Jiggolino/Hexapod/docs/Hexapod_Projektdokumentation_250919.docx

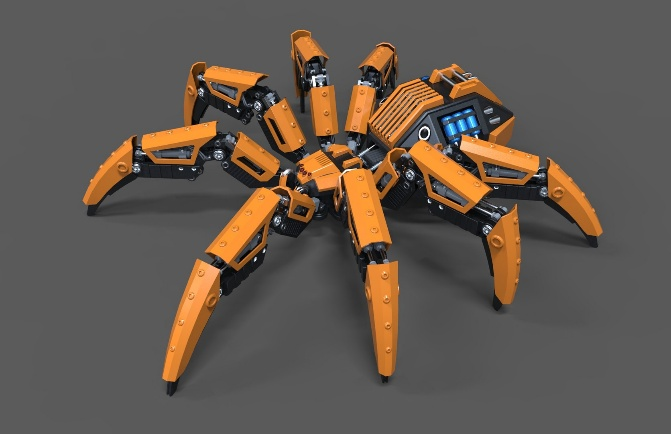
[picture p1: figure]
3d Model Robot Spider

# HEXAPOD

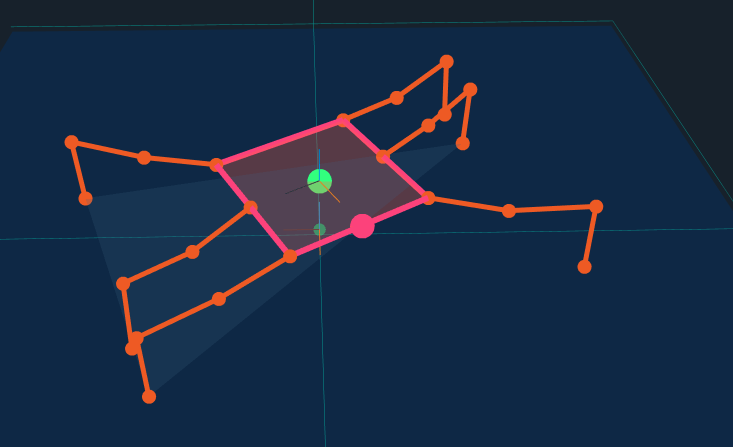
[picture p2: figure]
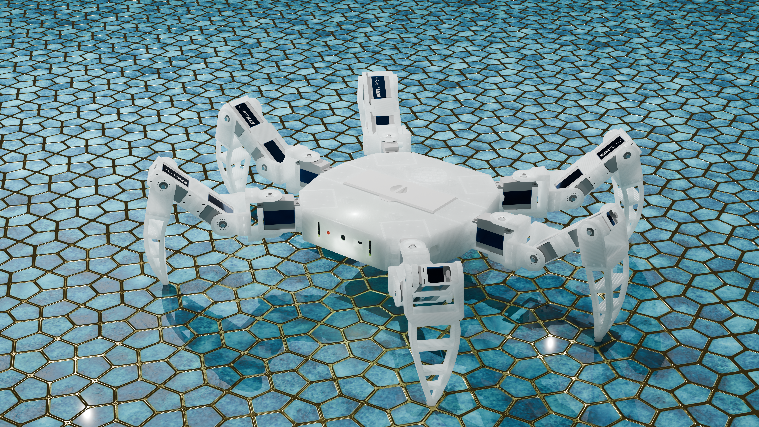
[picture p3: figure]
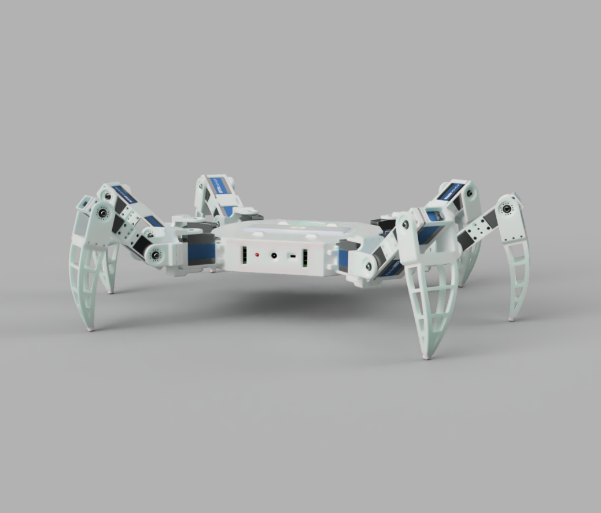
[picture p4: figure]
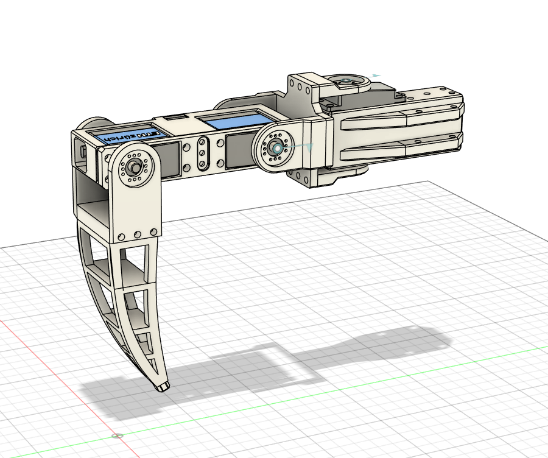
[picture p5: figure]
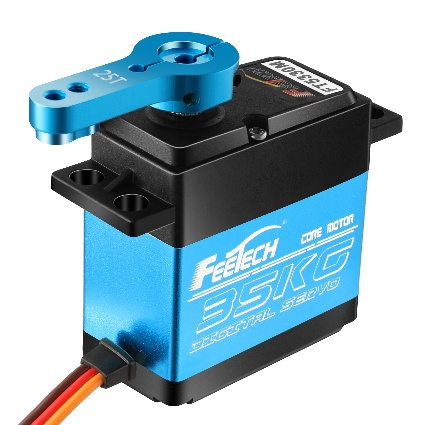
[picture p6: figure]
Servo Standard 35kg.cm Metal Gears (Feetech FT5330M)
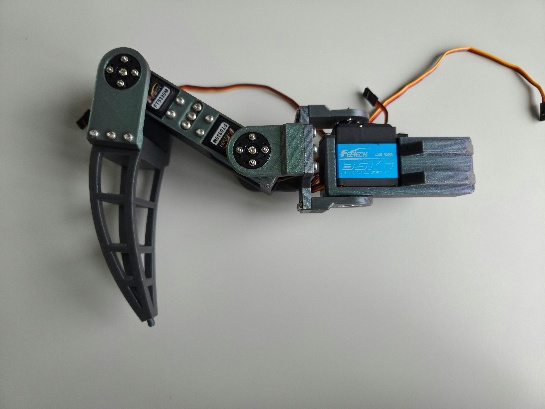
[picture p7: figure]
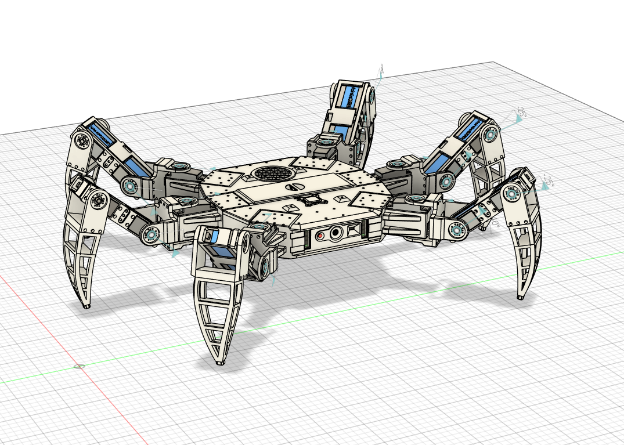
[picture p8: figure]

# Einleitung

Die Idee für dieses Projekt entstand, als ich auf YouTube den Kanal StewartTechnologies entdeckt habe. Dort habe ich zum ersten Mal einen Hexapod gesehen. Ein Hexapod ist ein Roboter mit sechs Beinen, der sich dadurch ganz anders bewegt als viele andere Roboter. Im Vergleich zu Robotern mit Rädern kann er auch auf unebenem Boden stabil stehen und sich fortbewegen. Im Gegensatz zu zweibeinigen oder vierbeinigen Robotern hat er durch die sechs Beine eine hohe Standfestigkeit, da immer mehrere Beine Bodenkontakt haben. Das macht ihn sehr vielseitig und für viele Experimente interessant.

Ein Hexapod gehört zu den sogenannten Beinrobotern. Diese Roboter sind besonders spannend, weil sie Bewegungen nachahmen, die man sonst nur aus der Natur kennt, zum Beispiel von Insekten oder Spinnen. Durch die vielen Gelenke in den Beinen kann ein Hexapod in alle Richtungen laufen und sich sogar drehen, ohne den Platz zu wechseln.

In diesem Projekt soll ein eigener Hexapod entwickelt und gebaut werden. Das Ziel ist es, ein Modell zu erstellen, das leicht, stabil und einfach steuerbar ist. Neben den grundlegenden Funktionen wie der Fernsteuerung und der sicheren Stromversorgung soll der Roboter auch modular aufgebaut sein, damit er später erweitert oder angepasst werden kann. Dieses Projekt verbindet Mechanik, Elektronik und Programmierung und soll zeigen, wie vielseitig ein Hexapod eingesetzt werden kann.

# Anforderungen

Ich habe eine Anforderungsliste in Excel gemacht mit 2 Spalten, Funktionale und Nicht Funktionale. Das Beispiel von Herr Jäger wurde als Vorlage für meine Anforderungsliste genommen. Man kann die Liste unter:/Hexapod/ requirements/ Hexapod_Anforderung_250916.xlsx oder unten auf dem Bild.

- Das Hexapod kann per Fernbedienung gesteuert werden. Begründung: Eine Fernsteuerung macht die Bedienung einfach und erlaubt es, das Hexapod flexibel einzusetzen.
- Jedes Bein kann sich in allen Achsen bewegen. Begründung: Dadurch sind viele Bewegungsarten möglich, was das Hexapod vielseitiger macht.
- Das Hexapod wird mit 6V–8,4V gespeist. Begründung: Dieser Spannungsbereich ist ideal für die eingesetzten Servomotoren und Elektronik.
- Das Hexapod kann 500g Extragewicht tragen. Begründung: Damit ist es möglich, zusätzliche Sensoren oder Module zu befestigen.
- Das Hexapod hat einen Indikator, der anzeigt, wenn die Kamera benutzt wird. Begründung: Dies erhöht die Sicherheit und macht klar sichtbar, ob gerade eine Videoaufnahme läuft.
- Das Hexapod muss in jeder Situation in den Zustand „unarmed“ gebracht werden können. Begründung: Dadurch kann man das Hexapod im Notfall sofort stoppen und Schäden vermeiden.
- Der Akku kann konstant überwacht und per Software ausgeschaltet werden. Begründung: So wird der Akku geschützt und eine sichere Nutzung gewährleistet.
- Die Leistungsaufnahme darf maximal 850W betragen. Begründung: Diese Begrenzung verhindert Überlastung und Schäden an den Bauteilen.
- Das Hexapod hat einen Anschluss für Erweiterungen (I2C, 5V, GND, 2x GPIO). Begründung: Mit diesen Anschlüssen können später zusätzliche Module einfach angeschlossen werden.
- Es gibt einen Überstromschutz und einen Unterspannungsschutz für den Akku. Begründung: Diese Schutzfunktionen verlängern die Lebensdauer des Akkus und erhöhen die Sicherheit.
- Der Controller ist ein PlayStation-Controller. Begründung: Ein PlayStation-Controller ist weit verbreitet, einfach zu bedienen und bietet viele Tasten für Steuerbefehle.
- Das Hexapod wiegt unter 3kg. Begründung: Ein geringes Gewicht macht den Transport einfacher und schont die Servomotoren.
- Der 3D-Druck wird mit PETG oder ABS ausgeführt. Begründung: Diese Materialien sind stabil und hitzebeständig, was für die Belastung im Betrieb wichtig ist.
- Das Hexapod ist mit ausgestreckten Beinen kürzer als 1 Meter. Begründung: Dadurch bleibt der Roboter handlich und gut transportierbar.
- Das Mainboard ist ein Eigendesign. Begründung: Ein eigenes Design kann optimal an die Anforderungen des Projekts angepasst werden.
- So viele Teile wie möglich sollen verschraubt und so wenig Klebstoff wie möglich verwendet werden. Begründung: Verschraubte Teile sind stabiler und lassen sich leichter reparieren oder austauschen.
- Das Hexapod darf 80°C nicht überschreiten. Begründung: Überhitzung kann Bauteile beschädigen und die Sicherheit gefährden.
- Das Hexapod muss im „unarmed“-Zustand programmierbar sein. Begründung: Damit können Änderungen gemacht werden, ohne dass eine Gefahr durch Bewegungen entsteht.
- Das Hexapod hat eine IMU (Internal Measurement Unit). Begründung: Die IMU misst Beschleunigung und Drehung, was für eine präzise Steuerung wichtig ist.
- Die Batterie kann einfach und schnell ausgetauscht werden. Begründung: Dies spart Zeit beim Betrieb und macht das Hexapod praktischer.
- Jedes Bein kann einzeln entfernt werden. Begründung: Dadurch sind Reparaturen einfacher möglich und defekte Teile können schnell ersetzt werden.
- Das Hexapod muss auch im zusammengebauten Zustand programmierbar sein. Begründung: So können Updates oder Änderungen ohne Auseinanderbauen gemacht werden.
- Die Füsse sind austauschbar. Begründung: Je nach Untergrund können passende Füsse eingesetzt werden, was die Einsatzmöglichkeiten erweitert.

Funktionale Anforderungen
# | Anforderung | Status

1 | Das Hexapod kann per Fernbedienung gesteuert werden. | Vom Kunden abgenommen
2 | Jedes Bein kann sich in allen Achsen bewegen. | Vom Kunden abgenommen
3 | Das Hexapod wird mit 6V-8,4V gespeist werden. | Vom Kunden abgenommen
4 | Das Hexapod kann 500g Extragewicht tragen. | Vom Kunden abgenommen
5 | Das Hexapod hat einen Indikator, der anzeigt, wenn die Kamera benutzt wird. | Vom Kunden abgenommen
6 | Das Hexapod muss in jeder situation in den Zustand "unarmed" gebracht werden können | Vom Kunden abgenommen
7 | Der Akku kann konstant überwacht und per Software ausgeschalten werden können. | Vom Kunden abgenommen
8 | Die Leistungsaufnahme kann maximal 850W betragen. | Vom Kunden abgenommen
9 | das Hexapod hat einen Anschluss für Erweiterungen mit folgenden Anschlüsse: I2C, 5V, GND, 2x GPIO | Vom Kunden abgenommen
10 | Es hat einen Überstromschutz und eine Unterspannungsschutz für den Akku. | Vom Kunden abgenommen
11 | Der Controller ist ein PlayStation-Controller. | Vom Kunden abgenommen
11 | Das Hexapod wiegt unter 3kg. | Vom Kunden abgenommen

Nichtfunktionale Anforderungen
# | Anforderung | Status

1 | Der 3D-Druck wird mit PETG oder ABS gedruckt werden. | Vom Kunden abgenommen
2 | Das Hexapod ist mit ausgestreckten Beinen unter einem Meter lang. | Vom Kunden abgenommen
3
4 | Das Mainboard ist ein Eigendesign. | Vom Kunden abgenommen
5 | Es sollen so viele Teile wie möglich verschraubt und so wenig Klebstoff wie möglich verwendet werden. | Vom Kunden abgenommen
6 | Das Hexapod darf 80°C nicht überschreiten. | Vom Kunden abgenommen
7 | Das Hexapod muss im "unarmed" Zustand programmierbar sein. | Vom Kunden abgenommen
8 | Das Hexapod hat eine IMU (Internal Mesurment Unit, kann beschleunigung und rotation in allen Achsen messen). | Vom Kunden abgenommen
9 | Die Batterie kann einfach und schnell ausgetaust werden. | Vom Kunden abgenommen
10 | Jedes Bein kann einzeln entfernt werden. | Vom Kunden abgenommen
11 | Das Hexapod muss auch im komplett zusammengebauten Zustand noch programmierbar sein. | Vom Kunden abgenommen
12 | Die Füße sind austauschbar sein. | Vom Kunden abgenommen

# Planung

Für die Planung des Projekts habe ich mir zuerst ein geeignetes Tool ausgesucht. Nach dem Vergleichen mehrerer Möglichkeiten habe ich mich für das Online-Tool Miro entschieden. Dieses eignet sich besonders gut, weil ich von überall darauf zugreifen kann, es eine übersichtliche Benutzeroberfläche hat und die Erstellung von Plänen sehr einfach und flexibel ist.

Als das Tool feststand, habe ich begonnen, die Anforderungen in grobe Schritte und Meilensteine einzuteilen. Jeder Schritt bekam eine geschätzte Zeitdauer, und bei den Meilensteinen habe ich ein genaues Datum eingetragen. In dem Zeitplan haben die Schritte, an welchen ich arbeite, einen hellgrünen Rahmen und die schon gemacht sind haben einen grünen Rahmen. Ich habe Dazu auch noch die Meilensteine in verschiedenen Farben eingefärbt. Die Zeitangaben habe ich möglichst realistisch geschätzt, basierend auf meinen bisherigen Erfahrungen. Am Ende habe ich die geschätzten Zeiten addiert, den Wert verdoppelt und zusätzlich 50 Stunden dazugezählt. Der Grund dafür ist, dass man sich bei Projekten oft verschätzt und viele Arbeiten mehr Zeit beanspruchen, als man zuerst denkt. So kam ich auf eine Gesamtzeit von rund 250 Stunden.

Der Zeitplan beginnt am 28.08.2025 mit der Projektbeschreibung, dem organisatorischen Teil und der Erstellung des Zeitplans. Danach folgt die Suche nach geeigneten Servomotoren, der Kauf von drei Servos und der erste 3D-Entwurf für ein Bein. Dieses Bein wird gedruckt, zusammengebaut und getestet. So entsteht bis zum 26.09.2025 der erste Prototyp.

Im nächsten Schritt wird das Design des Körpers entwickelt und die restlichen Teile werden gesucht. Nach dem ersten fertigen 3D-Design am 09.10.2025 folgen das Drucken des Körpers und die Überarbeitung der Beine. Danach werden fünf weitere Beine gedruckt, sodass am 12.11.2025 das finale 3D-Design abgeschlossen ist. Anschliessend wird das Hexapod zum ersten Mal komplett zusammengesetzt.

Parallel dazu wird die Elektronik geplant. Dazu gehört das Design der eigenen Leiterplatte (PCB), das Bestellen der Bauteile und die Fertigung der Platine. Am 19.11.2025 ist die finale Platine fertiggestellt. Danach wird die Elektronik mit Oszilloskop und Multimeter getestet und in das Hexapod eingebaut.

Am 10.12.2025 steht der erste komplette Aufbau des Hexapods. Danach beginnt eine längere Testphase von rund 16 Stunden. Dabei werden Fehler im Design gesucht und behoben. Am 08.01.2026 ist die Dokumentation abgeschlossen, und am 09.01.2026 ist das Hexapod so weit, dass es funktioniert und präsentiert werden kann.

In den letzten Tagen bis zum 15.01.2026 wird die Programmierung für die Demonstration vorbereitet, sodass das Hexapod am Ende in einer Vorführung präsentiert werden kann.

Man kann den Zeitplan unten Auf dem Bild sehen oder in dem Browser mit diesem Link:

https://miro.com/app/board/uXjVJN4mAOU=/

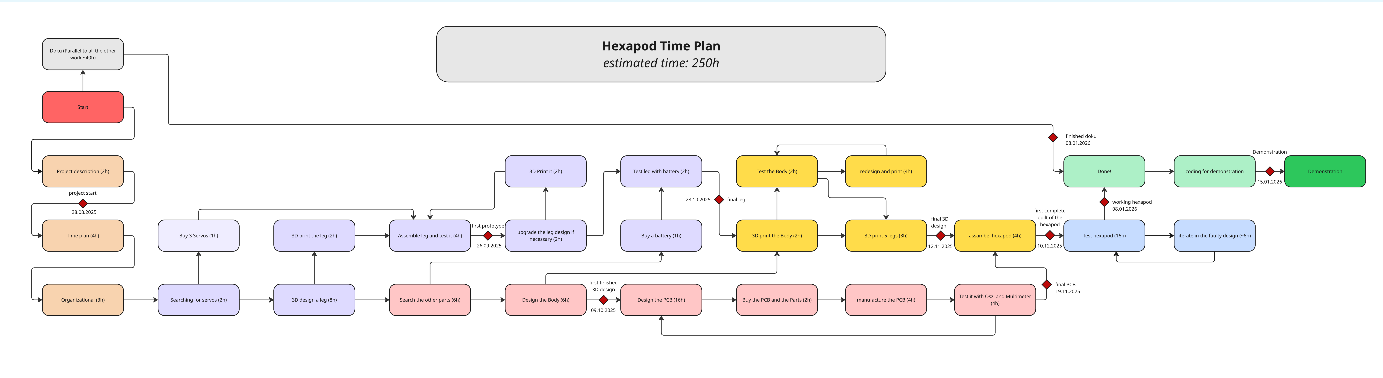
[picture p9: figure]

# Analyse

REPLACEME

# Realisierung

REPLACEME

# Testen

REPLACEME

# Reflektion

REPLACEME

# Selbständigkeitserklärung

REPLACEME

# Arbeitsjournal

In diesem Excelfile befindet sich das Arbeitsjournal.

# Anhang

REPLACEME

# Quellen

Ideen:

- https://www.youtube.com/@StewartTechnologies
- https://chatgpt.com/
- https://gemini.google.com/app

Bilder:

- https://p.turbosquid.com/ts-thumb/S3/DcNrTi/hCynQxiG/01.747/jpg/1530644260/1920x1080/fit_q87/9920db83fd3fdb3f5ec1dace9df54c11408f45dd/01.747.jpg
- https://grobotronics.com/images/detailed/118/hfe4c15bd1f4446558cd29e1a1951516ca_grobo.jpg
- https://hexapod.netlify.app/walking-gaits

Assets:

- https://grabcad.com/library/raspberry-pi-5-2
- https://grabcad.com/library/raspberry-pi-camera-4
- https://grabcad.com/library/raspberry-pi-5-active-cooler-1
- https://www.blenderkit.com/
- https://sketchfab.com/feed
- https://www.fab.com/
- https://www.snapeda.com/home/

19.09.2025 Seite 1 von 2

Hexapod Linus Meier
