Jiggolino/Hexapod/requirements/1_Semester/Hexapod_Anforderung_250916.xlsx

Funktionale Anforderungen |  |  | Nichtfunktionale Anforderungen
# | Anforderung | Status | # | Anforderung | Status
1 | Das Hexapod kann per Fernbedienung gesteuert werden. | Vom Kunden abgenommen | 1 | Der 3D-Druck wird mit PETG oder ABS gedruckt werden. | Vom Kunden abgenommen
2 | Jedes Bein kann sich in allen Achsen bewegen. | Vom Kunden abgenommen | 2 | Das Hexapod ist mit ausgestreckten Beinen unter einem Meter lang. | Vom Kunden abgenommen
3 | Das Hexapod wird mit 6V-8,4V gespeist werden. | Vom Kunden abgenommen | 3 | Das Mainboard ist ein Eigendesign. | Vom Kunden abgenommen
4 | Das Hexapod kann 500g Extragewicht tragen. | Vom Kunden abgenommen | 4 | Es sollen so viele Teile wie möglich verschraubt und so wenig Klebstoff wie möglich verwendet werden. | Vom Kunden abgenommen
5 | Das Hexapod hat einen Indikator, der anzeigt, wenn die Kamera benutzt wird. | Vom Kunden abgenommen | 5 | Das Hexapod darf 80°C nicht überschreiten. | Vom Kunden abgenommen
6 | Das Hexapod muss in jeder situation in den Zustand "unarmed" gebracht werden können | Vom Kunden abgenommen | 6 | Das Hexapod muss im "unarmed" Zustand programmierbar sein. | Vom Kunden abgenommen
7 | Der Akku kann konstant überwacht und per Software ausgeschalten werden können. | Vom Kunden abgenommen | 7 | Das Hexapod hat eine IMU (Internal Mesurment Unit, kann beschleunigung und rotation in allen Achsen messen). | Vom Kunden abgenommen
8 | Die Leistungsaufnahme kann maximal 850W betragen. | Vom Kunden abgenommen | 8 | Die Batterie kann einfach und schnell ausgetaust werden. | Vom Kunden abgenommen
9 | das Hexapod hat einen Anschluss für Erweiterungen mit folgenden Anschlüsse: I2C, 5V, GND, 2x GPIO | Vom Kunden abgenommen | 9 | Jedes Bein kann einzeln entfernt werden. | Vom Kunden abgenommen
10 | Es hat einen Überstromschutz und eine Unterspannungsschutz für den Akku. | Vom Kunden abgenommen | 10 | Das Hexapod muss auch im komplett zusammengebauten Zustand noch programmierbar sein. | Vom Kunden abgenommen
11 | Der Controller ist ein PlayStation-Controller. | Vom Kunden abgenommen | 11 | Die Füße sind austauschbar sein. | Vom Kunden abgenommen
11 | Das Hexapod wiegt unter 3kg. | Vom Kunden abgenommen
Funktionale Anforderungen Test |  |  | Nichtfunktionale Anforderungen Test
# | Anforderung | Status | # | Anforderung | Status | Column1
1 | Das Hexapod kann per Fernbedienung gesteuert werden. | Noch nicht Erreicht | 1 | Der 3D-Druck wird mit PETG oder ABS gedruckt werden. | Erreicht (PETG)
2 | Jedes Bein kann sich in allen Achsen bewegen. | Erreicht | 2 | Das Hexapod ist mit ausgestreckten Beinen unter einem Meter lang. | Erreicht (94.53cm)
3 | Das Hexapod wird mit 6V-8,4V gespeist werden. | Erreicht (5.8V-8.4V) | 3 | Das Mainboard ist ein Eigendesign. | Erreicht
4 | Das Hexapod kann 500g Extragewicht tragen. | Noch nicht Erreicht | 4 | Es sollen so viele Teile wie möglich verschraubt und so wenig Klebstoff wie möglich verwendet werden. | Erreicht (Alles aussert 2 Bauteile sind verschraubt)
5 | Das Hexapod hat einen Indikator, der anzeigt, wenn die Kamera benutzt wird. | Noch nicht Erreicht | 5 | Das Hexapod darf 80°C nicht überschreiten. | Erreicht (max temp = 65° (Raspberry pi 5 maximale core tempereatur)) | test unter vollast mit Ubuntu Server als OS
6 | Das Hexapod muss in jeder situation in den Zustand "unarmed" gebracht werden können | Noch nicht Erreicht | 6 | Das Hexapod muss im "unarmed" Zustand programmierbar sein. | Noch nicht Erreicht
7 | Der Akku kann konstant überwacht und per Software ausgeschalten werden können. | Noch nicht Erreicht | 7 | Das Hexapod hat eine IMU (Internal Mesurment Unit, kann beschleunigung und rotation in allen Achsen messen). | Erreicht
8 | Die Leistungsaufnahme kann maximal 850W betragen. | Noch nicht Erreicht | 8 | Die Batterie kann einfach und schnell ausgetaust werden. | Noch nicht Erreicht
9 | das Hexapod hat einen Anschluss für Erweiterungen mit folgenden Anschlüsse: I2C, 5V, GND, 2x GPIO | Erreicht (I2C, 5V 2x GPIO, 3.3V, 5.8-8.4V, ADC, SPI) | 9 | Jedes Bein kann einzeln entfernt werden. | Erreicht
10 | Es hat einen Überstromschutz und eine Unterspannungsschutz für den Akku. | Noch nicht Erreicht | 10 | Das Hexapod muss auch im komplett zusammengebauten Zustand noch programmierbar sein. | Erreicht
11 | Der Controller ist ein PlayStation-Controller. | Erreicht (PS5 Controller) | 11 | Die Füße sind austauschbar sein. | Erreicht
11 | Das Hexapod wiegt unter 3kg. | Nicht Erreicht (3.315Kg)
 |  |  |  |  | 9 von 11 Erreicht
Diese Test wurden von Linus Meier Durchgeführt am 07.01.2026 durchgeführt. |  | 4 von 11 Erreicht
