Jiggolino/Hexapod/requirements/2_Semester/Hexapod_Anforderung_250916.xlsx

Funktionale Anforderungen |  |  | Nichtfunktionale Anforderungen
# | Anforderung | Status | # | Anforderung | Status
1 | Das Hexapod kann per Fernbedienung gesteuert werden. | Vom Kunden abgenommen | 1 | Der Code ist Modular Aufgebaut dammit man Funktionen einfach ersetzen oder ändern kann | Vom Kunden abgenommen
2 | Jedes Bein kann sich in allen Achsen bewegen. | Vom Kunden abgenommen | 2 | Der Lowlevel code ist in C Programiert | Vom Kunden abgenommen
3 |  | Vom Kunden abgenommen | 3 | Die zeitkritischen funktionen werden mit einem Regelkreis und einer State-Mashine Programiert | Vom Kunden abgenommen
4 | Das Hexapod kann 500g Extragewicht tragen. | Vom Kunden abgenommen | 4 | Das benüzen der steuerung ist selbsterklärend | Vom Kunden abgenommen
5 | Das Hexapod hat einen Indikator, der anzeigt, wenn die Kamera benutzt wird. | Vom Kunden abgenommen | 5 | Es git eine Gebrauchsanleitung | Vom Kunden abgenommen
6 | Das Hexapod muss in jeder situation in den Ruhezustand gebracht werden können | Vom Kunden abgenommen | 6 | Die Einstellungen werden über ein WEB-Interface gemacht | Vom Kunden abgenommen
7 | Das Hexapod ist nicht Netzwerkabhängig | Vom Kunden abgenommen | 7 | Es gibt ein Realtime webinterface für alle sensoren und Daten | Vom Kunden abgenommen
8 | Es hat einen Überstromschutz und eine Unterspannungsschutz für den Akku. | Vom Kunden abgenommen | 8 | Jeder Code hat seine eigenen Tests und Protokolle | Vom Kunden abgenommen
9 | Der Controller ist ein PlayStation-Controller. | Vom Kunden abgenommen
10 | Man kann einfach zwischen den verschidenen kontrolirungs Methoden wechseln | Vom Kunden abgenommen
11 | Den Kamera feed kann man auf einem externen Blidschirm sich ansehen | Vom Kunden abgenommen
11 | Alle verzögerungen sollten unter 200ms sein | Vom Kunden abgenommen
12 | Der Regelkreis hat eine Frequenz von mindestens 50Hz für Zeitkritische aspekte | Vom Kunden abgenommen
