Jiggolino/Hexapod/parts/partlists/Mainboard/Parts.xlsx

Part list PCB
Purpose | part | seller | partnumber | manufacturer | datasheet | price | quantity | total price
ADC | ADS1115IRUGT | Digikey | 296-24935-1-ND | Texas Instruments | https://www.ti.com/lit/ds/symlink/ads1113.pdf?HQS=dis-dk-null-digikeymode-dsf-pf-null-wwe&ts=1756132663292 | CHF 5.03 | 1 | CHF 5.03
uC | ESP32-S3-WROOM-1-N8R8 | Digikey | 5407-ESP32-S3-WROOM-1-N8R8TR-ND | Espressif Systems | https://www.espressif.com/sites/default/files/documentation/esp32-s3-wroom-1_wroom-1u_datasheet_en.pdf | CHF 4.90 | 1 | CHF 4.90
PWM | PCA9685PW,118 | Digikey | 568-11925-1-ND | NXP USA Inc. | https://www.nxp.com/docs/en/data-sheet/PCA9685.pdf | CHF 2.21 | 2 | CHF 4.42
3.3V fixed regulator | AZ1117CH-3.3TRG1 | Digikey | AZ1117CH-3.3TRG1DITR-ND | Diodes Incorporated | https://www.diodes.com/assets/Datasheets/AZ1117C.pdf | CHF 0.13 | 1 | CHF 0.13
power MOSFET 100A | CSD17570Q5B | Digikey | 296-39993-2-ND | Texas Instruments | https://www.ti.com/general/docs/suppproductinfo.tsp?distId=10 | CHF 1.90 | 2 | CHF 3.80
MOFET / POWER EN | AO3400A | Digikey | 785-1000-2-ND | Alpha & Omega Semiconductor Inc. | https://mm.digikey.com/Volume0/opasdata/d220001/medias/docus/1133/AO3400A_ds.pdf | CHF 0.37 | 4 | CHF 1.48
USB C port | USB4105-GF-A | Digikey | 2073-USB4105-GF-ATR-ND | GCT | https://gct.co/files/specs/usb4105-spec.pdf | CHF 0.62 | 1 | CHF 0.62
PD Controller | AP33771DKZ-13 | Digikey | 31-AP33771DKZ-13TR-ND | Diodes Incorporated | https://www.diodes.com/assets/Datasheets/AP33771.pdf | CHF 1.42 | 1 | CHF 1.42
Level Shifter | TXS0102DCUR | Digikey | 296-21931-2-ND | Texas Instruments | https://www.ti.com/lit/ds/symlink/txs0102.pdf?ts=1756187465447 | CHF 0.56 | 1 | CHF 0.56
IMU | LSM6DSO32TR | Digikey | 497-LSM6DSO32CT-ND | STMicroelectronics | https://www.st.com/resource/en/datasheet/lsm6dso32.pdf | CHF 3.64 | 1 | CHF 3.64
OPV current sensing 200x | INA181A3IDBVR | Digikey | 296-47658-2-ND | Texas Instruments | https://www.ti.com/lit/ds/symlink/ina181.pdf | CHF 0.43 | 2 | CHF 0.86
 |  |  |  |  |  | CHF 0.00 | 0 | CHF 0.00
 |  |  |  |  |  | CHF 0.00 | 0 | CHF 0.00
 |  |  |  |  |  | CHF 0.00 | 0 | CHF 0.00
 |  |  |  |  |  | CHF 0.00 | 0 | CHF 0.00
 |  |  |  |  |  | CHF 0.00 | 0 | CHF 0.00
 |  |  |  |  |  | CHF 0.00 | 0 | CHF 0.00
 |  |  |  |  |  | CHF 0.00 | 0 | CHF 0.00
 |  |  |  |  |  | CHF 0.00 | 0 | CHF 0.00
 |  |  |  |  |  | CHF 0.00 | 0 | CHF 0.00
 |  |  |  |  |  | CHF 0.00 | 0 | CHF 0.00
 |  |  |  |  |  | CHF 0.00 | 0 | CHF 0.00
 |  |  |  |  |  | CHF 0.00 | 0 | CHF 0.00
 |  |  |  |  |  | CHF 0.00 | 0 | CHF 0.00
 |  |  |  |  |  | CHF 0.00 | 0 | CHF 0.00
 |  |  |  |  |  | CHF 0.00 | 0 | CHF 0.00
 |  |  |  |  |  | CHF 0.00 | 0 | CHF 0.00
 |  |  |  |  |  | CHF 0.00 | 0 | CHF 0.00
 |  |  |  |  |  | CHF 0.00 | 0 | CHF 0.00
 |  |  |  |  |  | CHF 0.00 | 0 | CHF 0.00
 |  |  |  |  |  | CHF 0.00 | 0 | CHF 0.00
 |  |  |  |  |  | CHF 0.00 | 0 | CHF 0.00
 |  |  |  |  |  | CHF 0.00 | 0 | CHF 0.00
 |  |  |  |  |  | CHF 0.00 | 0 | CHF 0.00
 |  |  |  |  |  | CHF 0.00 | 0 | CHF 0.00
 |  |  |  |  |  | CHF 0.00 | 0 | CHF 0.00
 |  |  |  |  |  | CHF 0.00 | 0 | CHF 0.00
 |  |  |  |  |  | CHF 0.00 | 0 | CHF 0.00
 |  |  |  |  |  | CHF 0.00 | 0 | CHF 0.00
 |  |  |  |  |  | CHF 0.00 | 0 | CHF 0.00
 |  |  |  |  |  | CHF 0.00 | 0 | CHF 0.00
 |  |  |  |  |  | CHF 0.00 | 0 | CHF 0.00
 |  |  |  |  |  |  | Total | CHF 26.86
