Jiggolino/Hexapod/estimates/1_Semester/hexapod_maximal_estimated_price.xlsx

Hexapod estimate price (maximum)
Items | estimated price per | quantity | final price
35Kg Servos 180 | 20.00 CHF | 20 | 400.00 CHF
Raspberry Pi 5 8GB | 80.00 CHF | 1 | 80.00 CHF
7.40 V, 7200 mAh Battery | 60.00 CHF | 2 | 120.00 CHF
fillament for 3D printing | 20.00 CHF | 3 | 60.00 CHF
screws | 0.20 CHF | 100 | 20.00 CHF
3D printinserts | 0.50 CHF | 30 | 15.00 CHF
cable sleves | 10.00 CHF | 2 | 20.00 CHF
PCB 5x + shipping | 30.00 CHF | 1 | 30.00 CHF
electronic parts | 40.00 CHF | 1 | 40.00 CHF
misc | 25.00 CHF | 1 | 25.00 CHF
 |  |  | 0.00 CHF
Old PS Controller | 10.00 CHF | 1 | 10.00 CHF
Shipping | 30.00 CHF | 1 | 30.00 CHF
 |  | Total: | 850.00 CHF
