Jiggolino/Hexapod/parts/partlists/led_strips/Parts.xlsx

Part list PCB
Purpose | part | seller | partnumber | manufacturer | datasheet | price | quantity | total price
LED White |  |  |  |  |  | CHF 0.00 | 0 | CHF 0.00
 |  |  |  |  |  | CHF 0.00 | 0 | CHF 0.00
 |  |  |  |  |  | CHF 0.00 | 0 | CHF 0.00
 |  |  |  |  |  | CHF 0.00 | 0 | CHF 0.00
 |  |  |  |  |  | CHF 0.00 | 0 | CHF 0.00
 |  |  |  |  |  | CHF 0.00 | 0 | CHF 0.00
 |  |  |  |  |  | CHF 0.00 | 0 | CHF 0.00
 |  |  |  |  |  | CHF 0.00 | 0 | CHF 0.00
 |  |  |  |  |  | CHF 0.00 | 0 | CHF 0.00
 |  |  |  |  |  | CHF 0.00 | 0 | CHF 0.00
 |  |  |  |  |  | CHF 0.00 | 0 | CHF 0.00
 |  |  |  |  |  | CHF 0.00 | 0 | CHF 0.00
 |  |  |  |  |  | CHF 0.00 | 0 | CHF 0.00
 |  |  |  |  |  | CHF 0.00 | 0 | CHF 0.00
 |  |  |  |  |  | CHF 0.00 | 0 | CHF 0.00
 |  |  |  |  |  | CHF 0.00 | 0 | CHF 0.00
 |  |  |  |  |  | CHF 0.00 | 0 | CHF 0.00
 |  |  |  |  |  | CHF 0.00 | 0 | CHF 0.00
 |  |  |  |  |  | CHF 0.00 | 0 | CHF 0.00
 |  |  |  |  |  | CHF 0.00 | 0 | CHF 0.00
 |  |  |  |  |  | CHF 0.00 | 0 | CHF 0.00
 |  |  |  |  |  | CHF 0.00 | 0 | CHF 0.00
 |  |  |  |  |  | CHF 0.00 | 0 | CHF 0.00
 |  |  |  |  |  | CHF 0.00 | 0 | CHF 0.00
 |  |  |  |  |  | CHF 0.00 | 0 | CHF 0.00
 |  |  |  |  |  | CHF 0.00 | 0 | CHF 0.00
 |  |  |  |  |  | CHF 0.00 | 0 | CHF 0.00
 |  |  |  |  |  | CHF 0.00 | 0 | CHF 0.00
 |  |  |  |  |  | CHF 0.00 | 0 | CHF 0.00
 |  |  |  |  |  | CHF 0.00 | 0 | CHF 0.00
 |  |  |  |  |  | CHF 0.00 | 0 | CHF 0.00
 |  |  |  |  |  | CHF 0.00 | 0 | CHF 0.00
 |  |  |  |  |  | CHF 0.00 | 0 | CHF 0.00
 |  |  |  |  |  | CHF 0.00 | 0 | CHF 0.00
 |  |  |  |  |  | CHF 0.00 | 0 | CHF 0.00
 |  |  |  |  |  | CHF 0.00 | 0 | CHF 0.00
 |  |  |  |  |  | CHF 0.00 | 0 | CHF 0.00
 |  |  |  |  |  | CHF 0.00 | 0 | CHF 0.00
 |  |  |  |  |  | CHF 0.00 | 0 | CHF 0.00
 |  |  |  |  |  | CHF 0.00 | 0 | CHF 0.00
 |  |  |  |  |  | CHF 0.00 | 0 | CHF 0.00
 |  |  |  |  |  | CHF 0.00 | 0 | CHF 0.00
 |  |  |  |  |  |  | Total | CHF 0.00
