Jiggolino/Hexapod/cad/sliced_files/Body/front cover.step

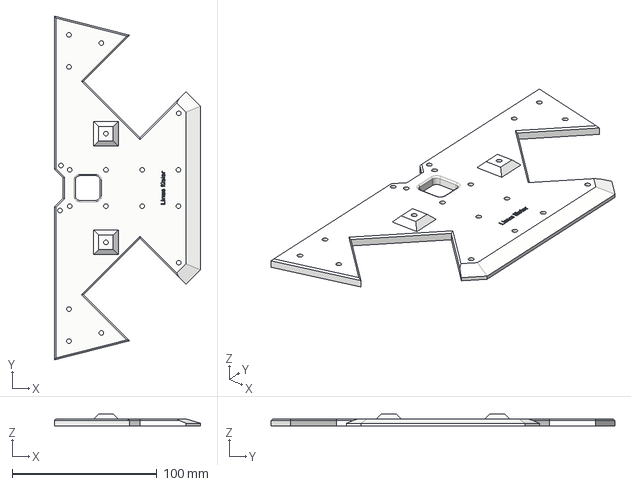
[picture p47: CAD file, 2026-04-13]
cad/sliced_files/Body/front cover.step
100.7 x 237.1 x 8.50 mm
