Jiggolino/Hexapod/cad/sliced_files/Body/Sliced/battery holder.step

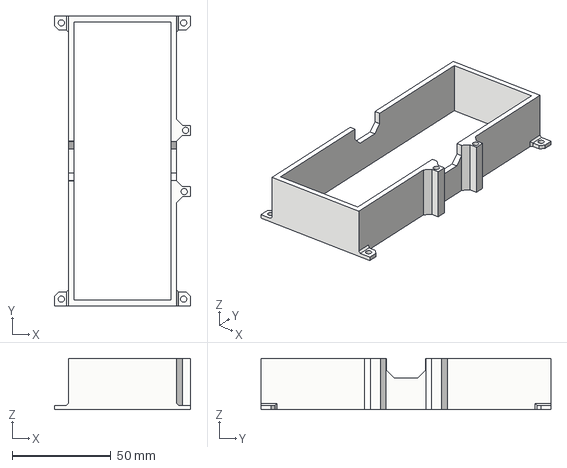
[picture p48: CAD file, 2026-04-13]
cad/sliced_files/Body/Sliced/battery holder.step
69.0 x 147.1 x 26.0 mm
