Jiggolino/Hexapod/cad/sliced_files/LEG_Final/Sliced/Done_Lower Leg.3mf

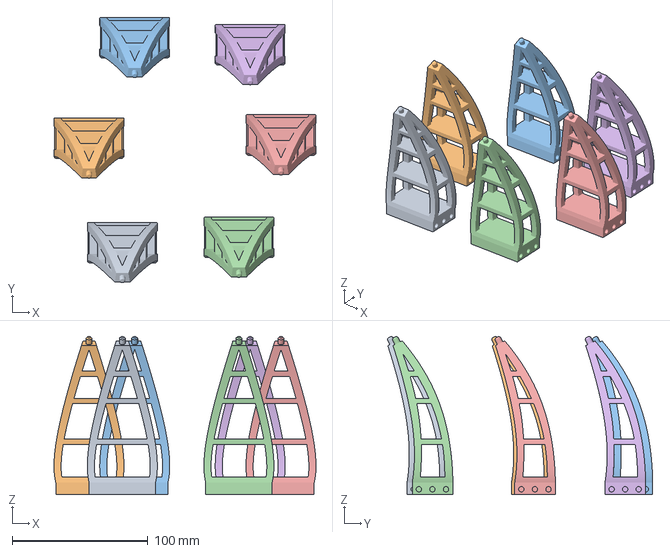
[picture p49: CAD file, 2026-03-23]
cad/sliced_files/LEG_Final/Sliced/Done_Lower Leg.3mf
193.3 x 195.8 x 116.6 mm
Lower Leg.stl x 6
