Jiggolino/Hexapod/cad/sliced_files/LEG_Final/Upper Leg lower hoop left.step

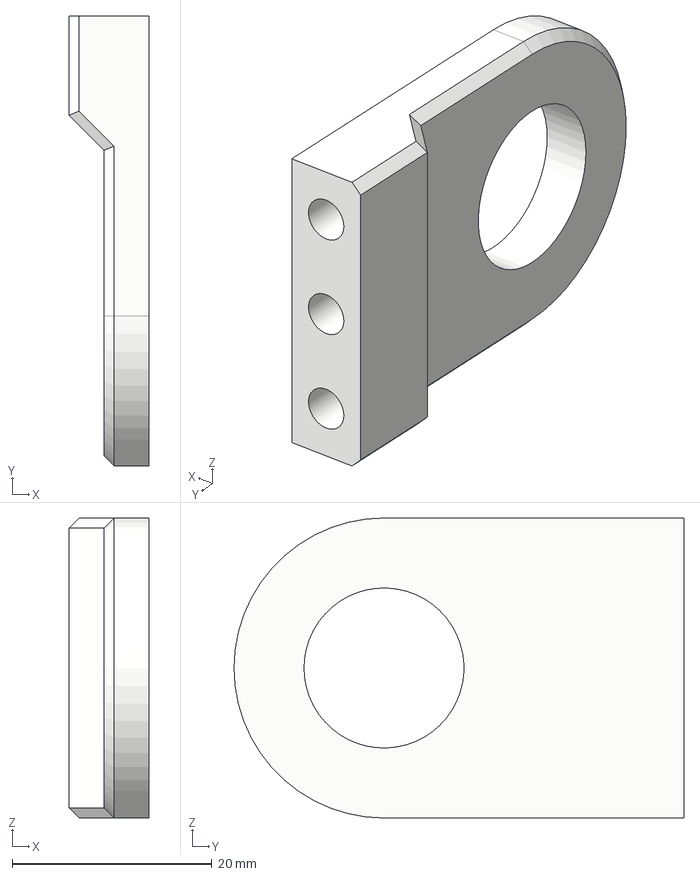
[picture p50: CAD file, 2026-04-13]
cad/sliced_files/LEG_Final/Upper Leg lower hoop left.step
8.00 x 45.0 x 30.0 mm
