Jiggolino/Hexapod/cad/sliced_files/LegV2/Upper Leg upper hoop top.3mf

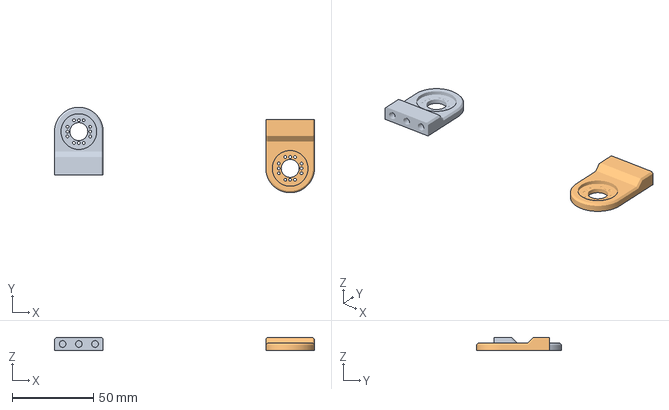
[picture p51: CAD file, 2025-09-30]
cad/sliced_files/LegV2/Upper Leg upper hoop top.3mf
160.3 x 52.7 x 8.00 mm
Upper Leg upper hoop top.step
Upper Leg lower hoop right.step
