Jiggolino/Hexapod/PCB/powerstrip_left/Footprints/LD1117S33TR/LD1117S33TR.step

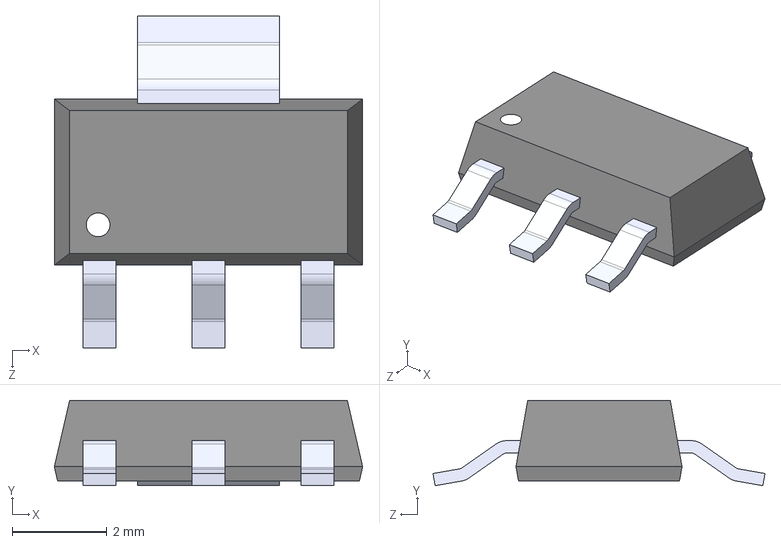
[picture p52: CAD file, 2026-03-23]
PCB/powerstrip_left/Footprints/LD1117S33TR/LD1117S33TR.step
6.50 x 1.80 x 7.00 mm
