Jiggolino/Hexapod/PCB/powerstrip_left/Footprints/LIB_PCA9685PW_Q900,118/PCA9685PW_Q900,118/3D/PCA9685PW_Q900,118.stp

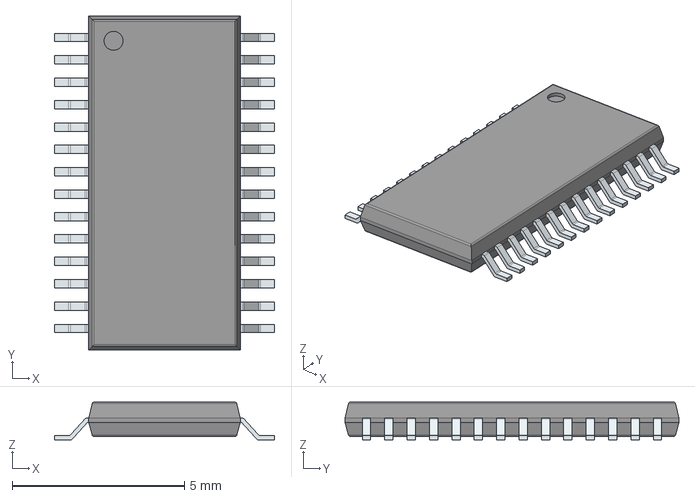
[picture p53: CAD file, 2025-11-03]
PCB/powerstrip_left/Footprints/LIB_PCA9685PW_Q900,118/PCA9685PW_Q900,118/3D/PCA9685PW_Q900,118.stp
6.40 x 9.70 x 1.10 mm
PinsArrayLR
