Jiggolino/Hexapod/PCB/powerstrip_left/Footprints/MUX508IDR/MUX508IDR.step

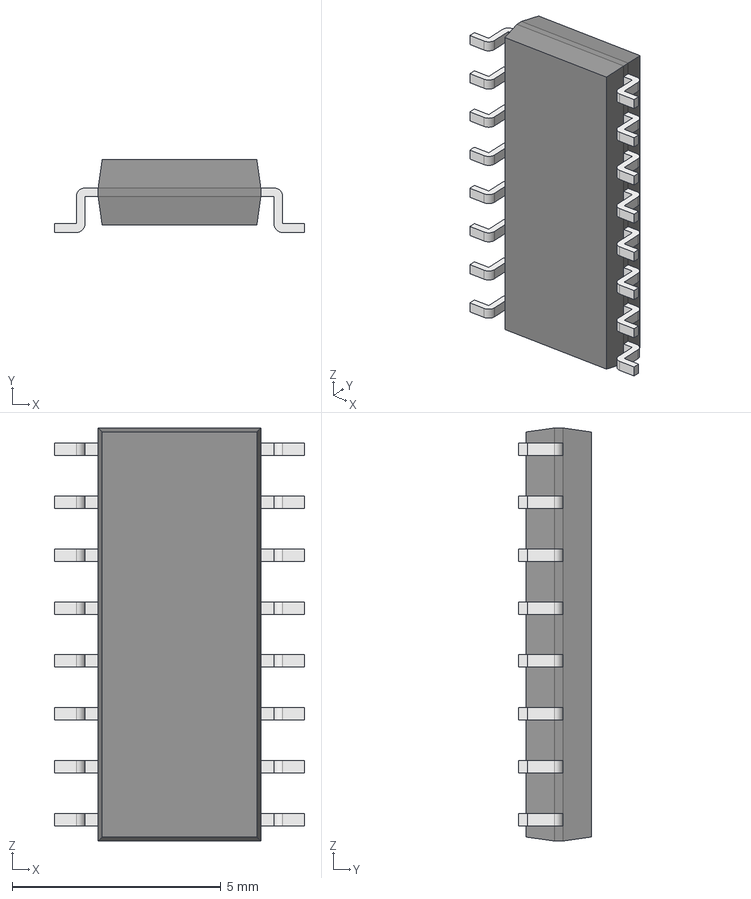
[picture p54: CAD file, 2025-11-03]
PCB/powerstrip_left/Footprints/MUX508IDR/MUX508IDR.step
6.00 x 1.75 x 9.90 mm
Body001 (Mirror #1) x 8
XY-plane x 12
X-axis x 12
