Jiggolino/Hexapod/PCB/powerstrip_left/powerstrip_left.step

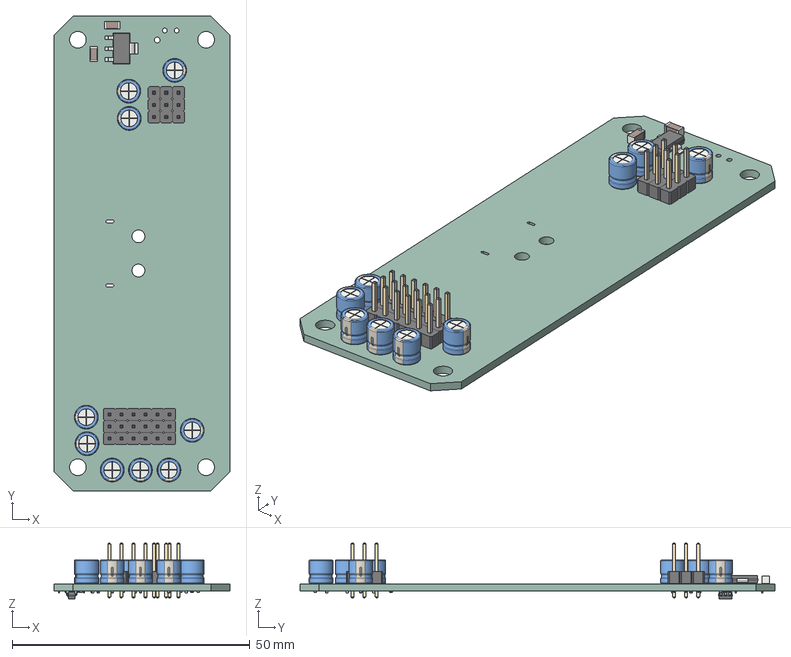
[picture p55: CAD file, 2025-11-11]
PCB/powerstrip_left/powerstrip_left.step
37.0 x 100.0 x 11.8 mm
CP_Radial_D5.0mm_P2.50mm x 9
SOT-223
PinHeader_1x03_P2.54mm_Vertical x 3
C_1206_3216Metric x 2
PinHeader_1x06_P2.54mm_Vertical x 3
C_0201_0603Metric x 4
R_0201_0603Metric x 8
SOT-23-6
powerstrip_left_PCB
