Jiggolino/Hexapod/cad/sliced_files/Body/back cover.step

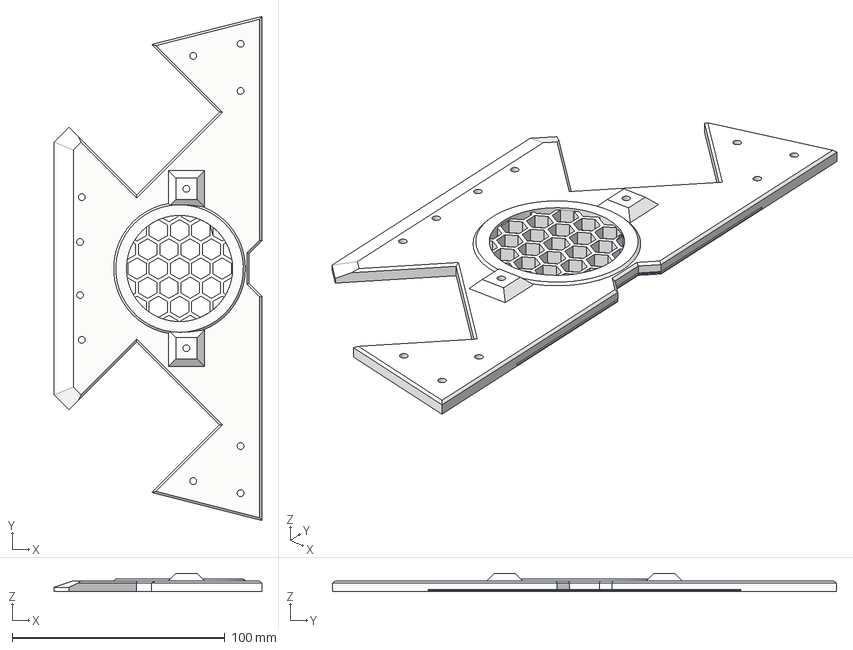
[picture p56: CAD file, 2026-04-13]
cad/sliced_files/Body/back cover.step
97.7 x 237.1 x 8.50 mm
