Jiggolino/Hexapod/cad/sliced_files/Body/Sliced/body.3mf

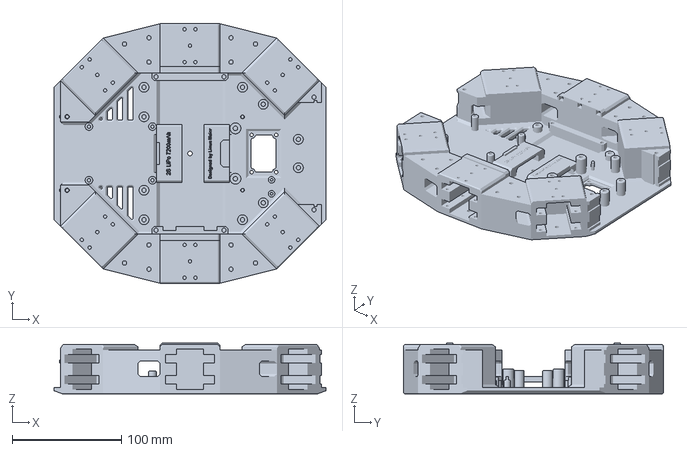
[picture p57: CAD file, 2026-03-23]
cad/sliced_files/Body/Sliced/body.3mf
248.4 x 237.1 x 46.5 mm
