Jiggolino/Hexapod/cad/sliced_files/LEG_Final/Middle Leg Back.step

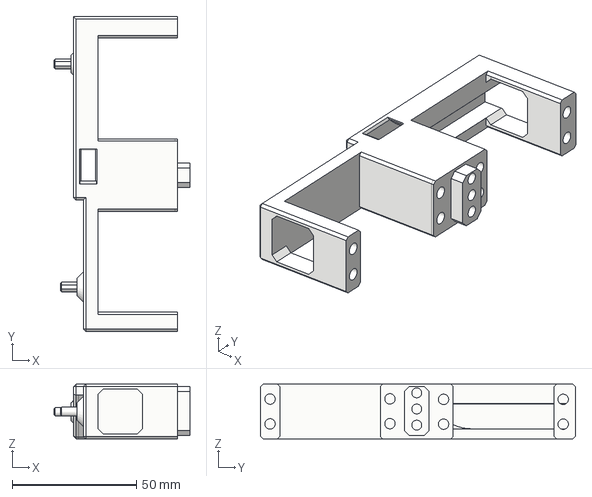
[picture p58: CAD file, 2026-04-13]
cad/sliced_files/LEG_Final/Middle Leg Back.step
54.8 x 127.0 x 22.0 mm
