Jiggolino/Hexapod/cad/sliced_files/LEG_Final/Sliced/Done_Upper Leg upper hoop bottom.3mf

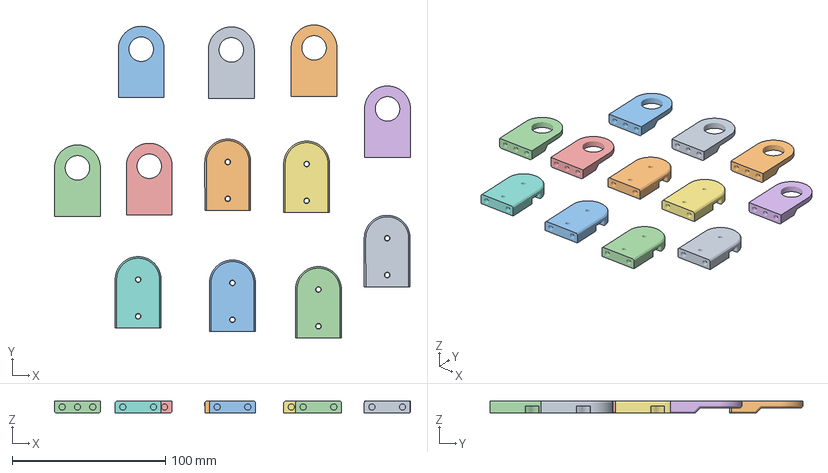
[picture p59: CAD file, 2026-03-23]
cad/sliced_files/LEG_Final/Sliced/Done_Upper Leg upper hoop bottom.3mf
232.6 x 204.5 x 8.00 mm
Upper Leg upper hoop bottom.step x 6
Upper Leg upper hoop top.step x 6
