Jiggolino/Hexapod/cad/sliced_files/LegV2/Conector_both_lower_loops_foot.3mf

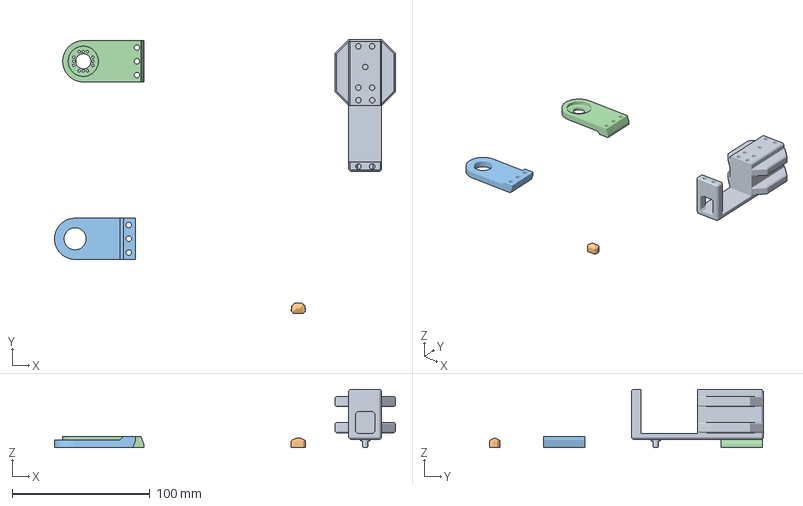
[picture p60: CAD file, 2025-09-30]
cad/sliced_files/LegV2/Conector_both_lower_loops_foot.3mf
248.0 x 199.3 x 42.2 mm
Conector.step
Foot.step
Lower Leg hoop left.step
Lower Leg hoop right.step
