Jiggolino/Hexapod/cad/sliced_files/Body/extention cover.step

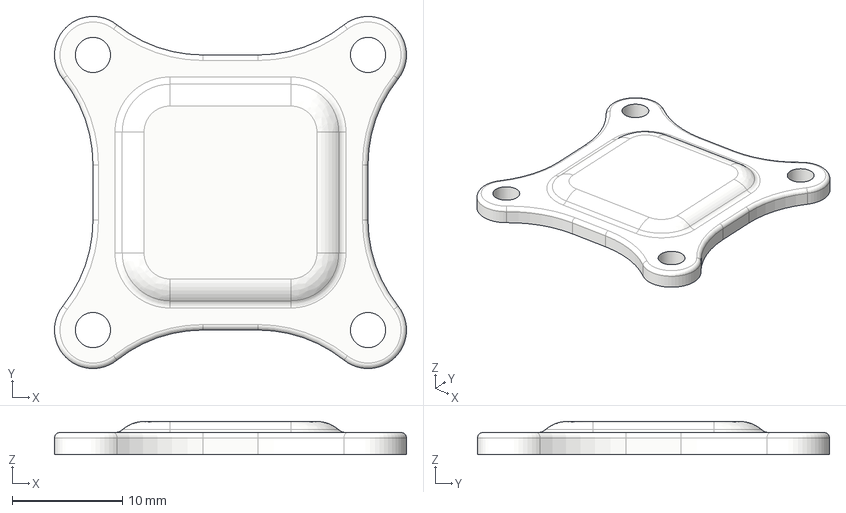
[picture p61: CAD file, 2026-04-13]
cad/sliced_files/Body/extention cover.step
32.0 x 32.0 x 3.00 mm
