Jiggolino/Hexapod/cad/sliced_files/Body/Sliced/body foot 1.3mf

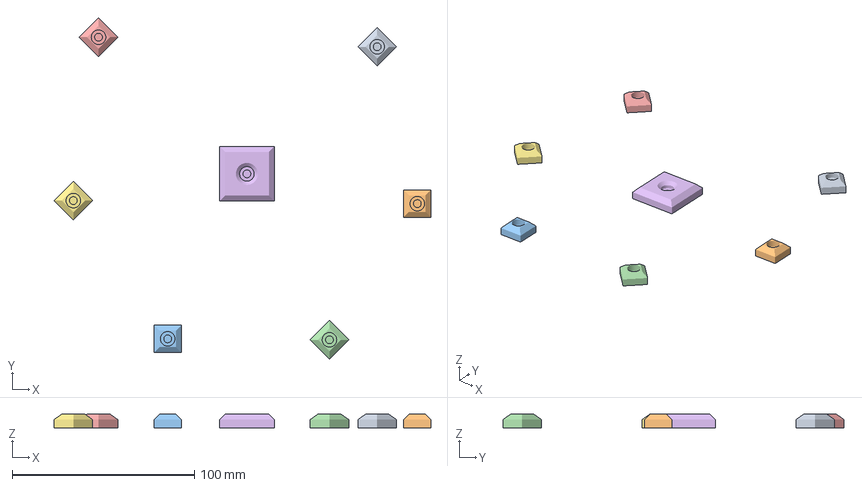
[picture p62: CAD file, 2026-03-23]
cad/sliced_files/Body/Sliced/body foot 1.3mf
206.8 x 187.2 x 7.50 mm
body foot 1.step
body foot 3.step
body foot 4.step
body foot 5.step
body foot 6.step
body foot middle.step
body foot.step
