Jiggolino/Hexapod/cad/sliced_files/LEG_Final/Middle Leg Front.step

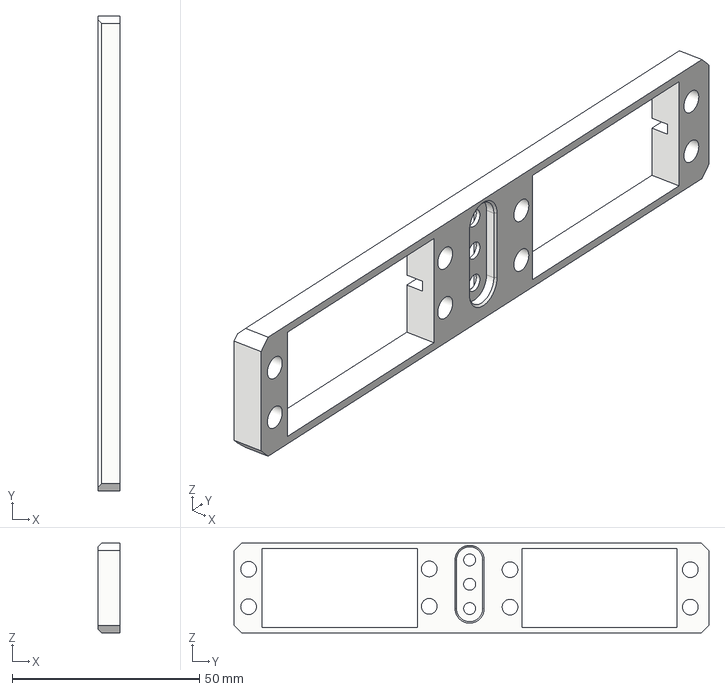
[picture p63: CAD file, 2026-04-13]
cad/sliced_files/LEG_Final/Middle Leg Front.step
6.00 x 127.0 x 24.0 mm
