Jiggolino/Hexapod/cad/sliced_files/LEG_Final/Sliced/Conector.3mf

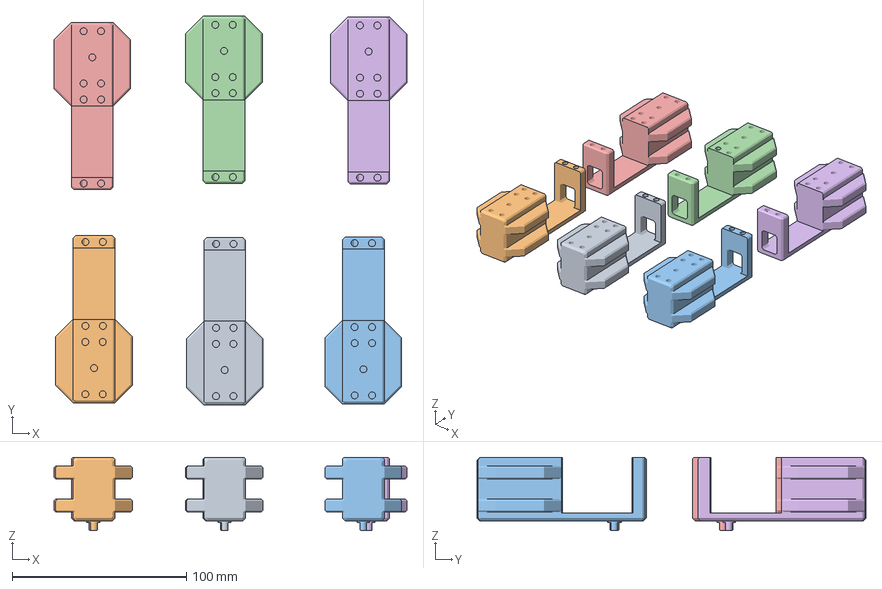
[picture p64: CAD file, 2026-03-23]
cad/sliced_files/LEG_Final/Sliced/Conector.3mf
202.7 x 223.2 x 42.2 mm
Conector.step x 6
