Jiggolino/Hexapod/cad/sliced_files/LegV2/Middle_Leg_front_and_back.3mf

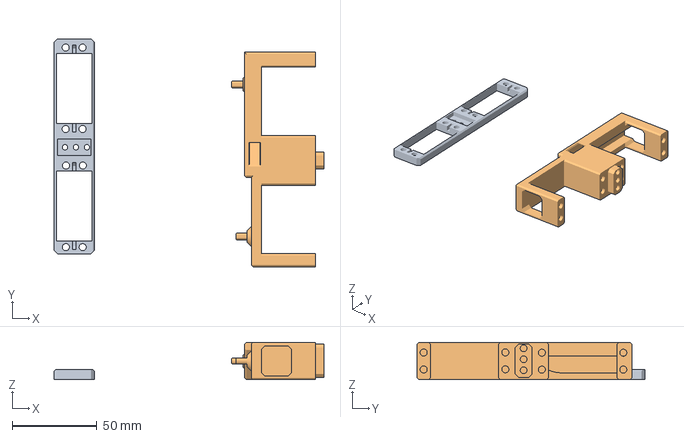
[picture p65: CAD file, 2025-09-30]
cad/sliced_files/LegV2/Middle_Leg_front_and_back.3mf
159.8 x 134.8 x 22.0 mm
Middle Leg Front.step
Middle Leg Back.step
