Jiggolino/Hexapod/cad/sliced_files/Body/Sliced/frontplate.3mf

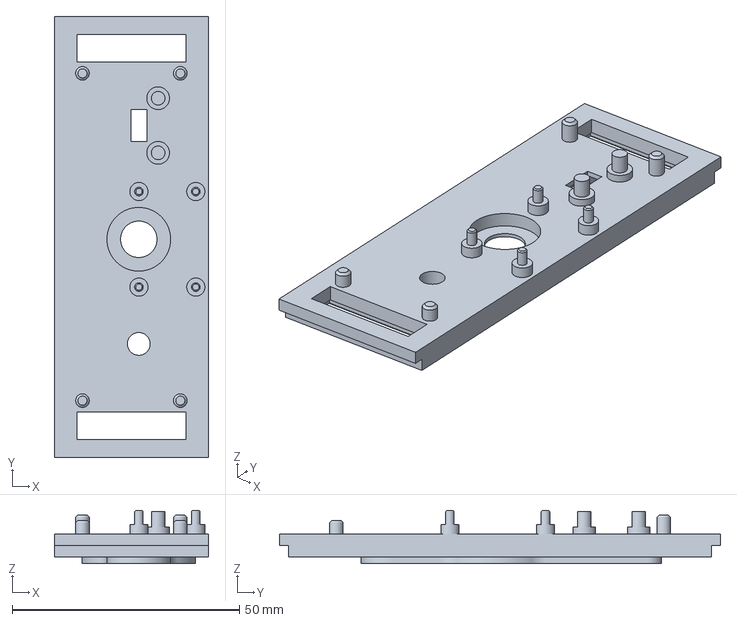
[picture p66: CAD file, 2026-03-23]
cad/sliced_files/Body/Sliced/frontplate.3mf
33.9 x 96.9 x 11.7 mm
