Jiggolino/Hexapod/cad/sliced_files/LEG_Final/Lower Leg hoop right.step

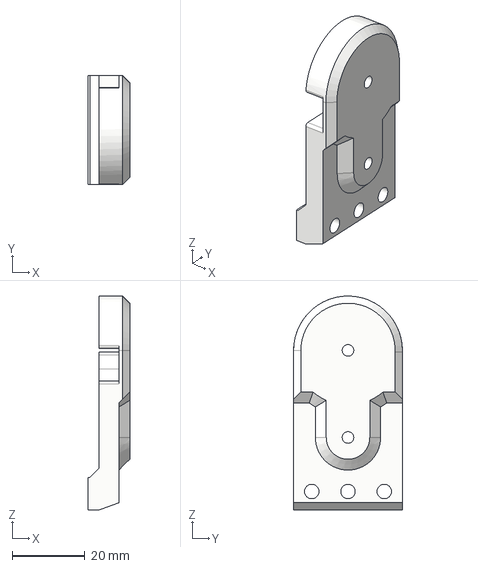
[picture p67: CAD file, 2026-04-13]
cad/sliced_files/LEG_Final/Lower Leg hoop right.step
11.5 x 30.0 x 59.0 mm
