Jiggolino/Hexapod/cad/sliced_files/LEG_Final/Sliced/correct_mirrord.3mf

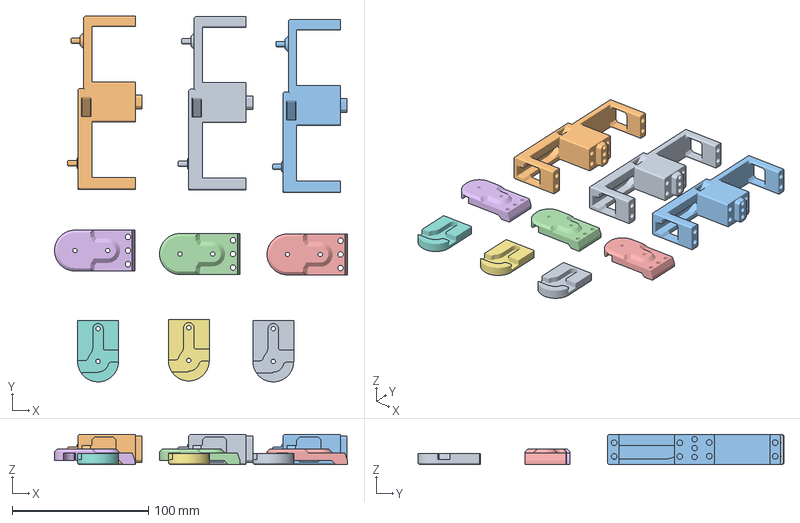
[picture p68: CAD file, 2026-03-23]
cad/sliced_files/LEG_Final/Sliced/correct_mirrord.3mf
214.8 x 268.2 x 22.0 mm
Middle Leg Back.step x 3
Lower Leg hoop right.step x 3
Upper Leg lower hoop right.step x 3
