Jiggolino/Hexapod/cad/sliced_files/LegV2/Upper_Leg_conector_and all_upper_hoops.3mf

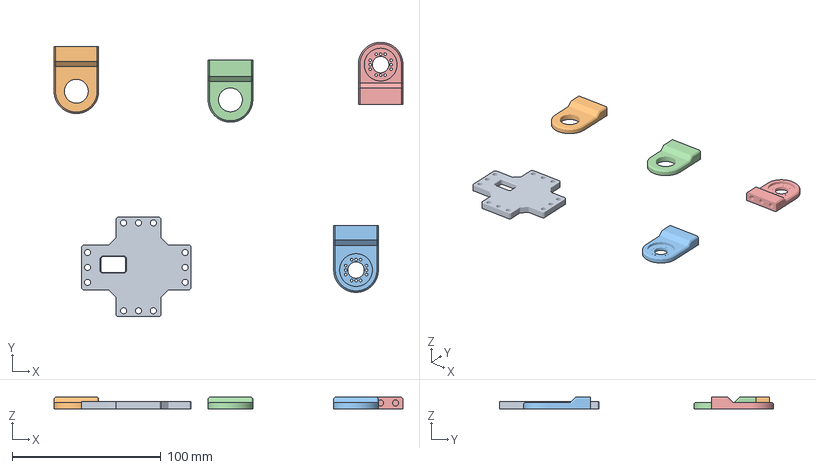
[picture p69: CAD file, 2025-09-30]
cad/sliced_files/LegV2/Upper_Leg_conector_and all_upper_hoops.3mf
234.2 x 184.2 x 8.00 mm
Upper Leg conector.step
Upper Leg lower hoop left.step
Upper Leg lower hoop right.step
Upper Leg upper hoop bottom.step
Upper Leg upper hoop top.step
