Jiggolino/Hexapod/cad/sliced_files/Body/Sliced/battery lid.3mf

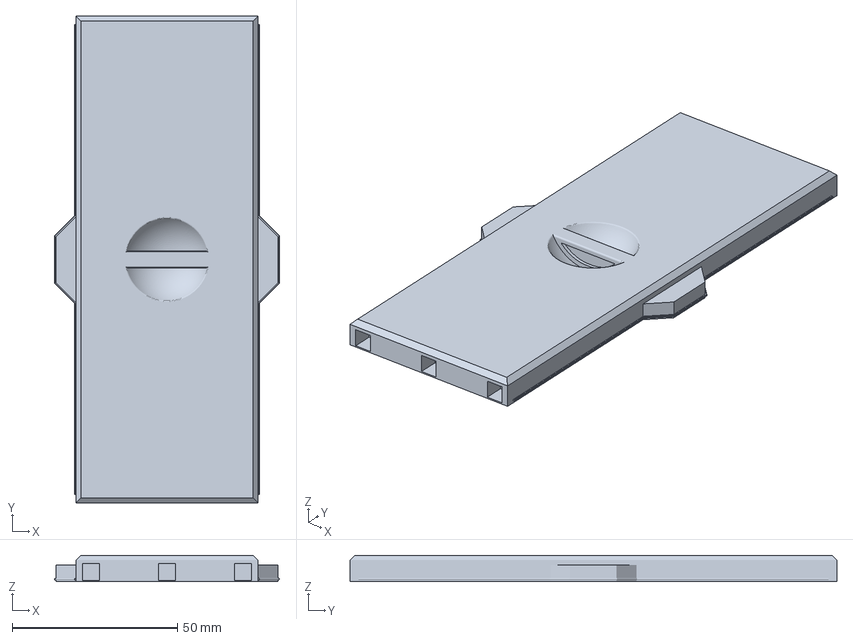
[picture p70: CAD file, 2026-03-23]
cad/sliced_files/Body/Sliced/battery lid.3mf
68.0 x 147.1 x 8.00 mm
