Jiggolino/Hexapod/cad/sliced_files/LEG_Final/Foot.step

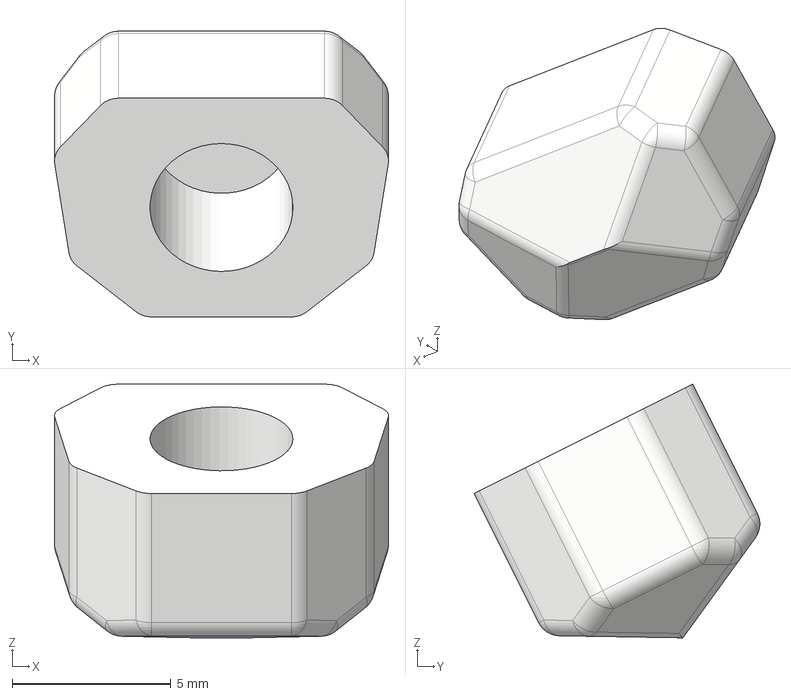
[picture p71: CAD file, 2026-04-13]
cad/sliced_files/LEG_Final/Foot.step
10.5 x 9.00 x 7.99 mm
