Jiggolino/Hexapod/cad/sliced_files/LEG_Final/Sliced/Done_Lower Leg hoop left.3mf

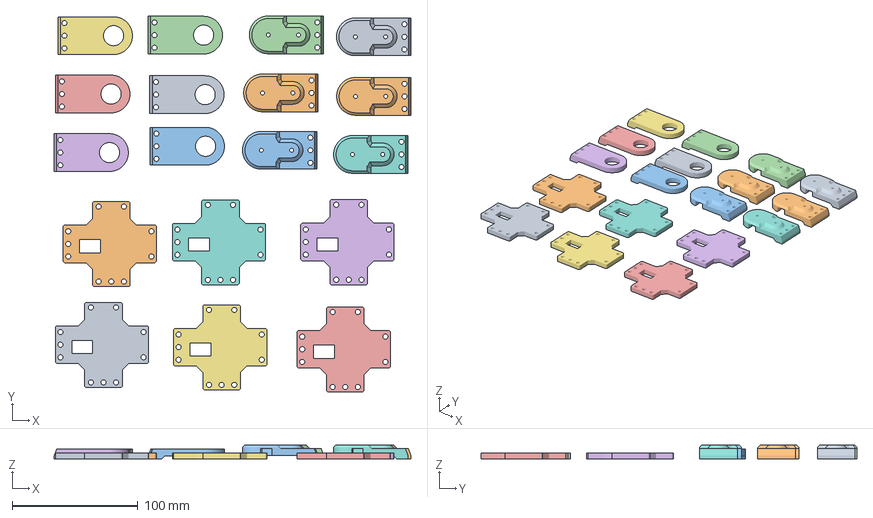
[picture p72: CAD file, 2026-03-23]
cad/sliced_files/LEG_Final/Sliced/Done_Lower Leg hoop left.3mf
283.3 x 298.4 x 11.5 mm
Lower Leg hoop left.step x 6
Lower Leg hoop right.step x 6
Upper Leg conector.step x 6
