Jiggolino/Hexapod/cad/sliced_files/LEG_Final/Sliced/ProzessMiddle Leg Back.3mf

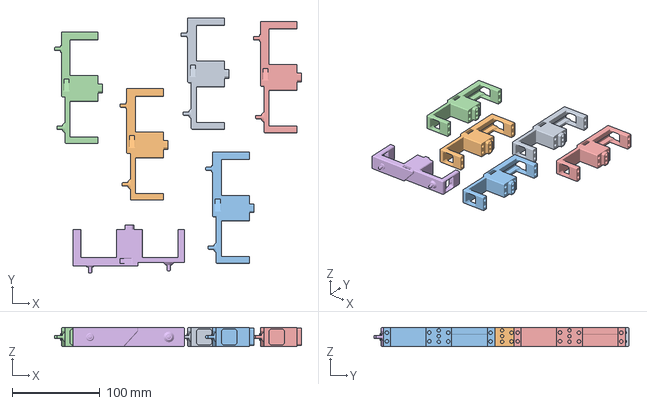
[picture p73: CAD file, 2026-03-23]
cad/sliced_files/LEG_Final/Sliced/ProzessMiddle Leg Back.3mf
281.5 x 290.7 x 22.0 mm
Middle Leg Back.step x 6
