Jiggolino/Hexapod/cad/sliced_files/LEG_Final/Upper Leg conector.step

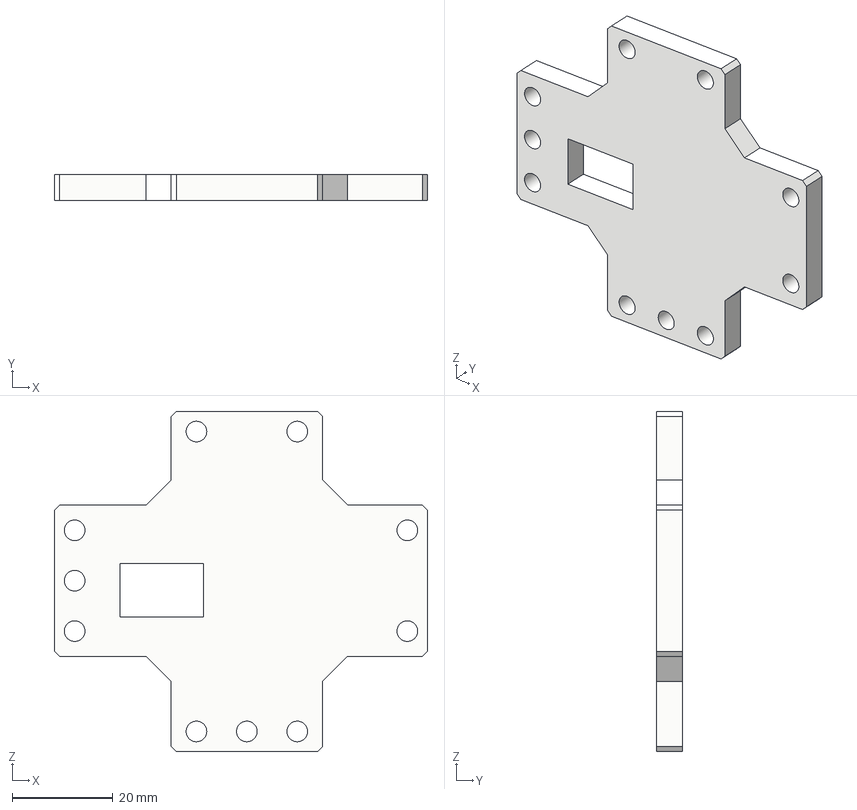
[picture p74: CAD file, 2026-04-13]
cad/sliced_files/LEG_Final/Upper Leg conector.step
74.0 x 5.10 x 67.5 mm
