Jiggolino/Hexapod/cad/sliced_files/Body/Sliced/back cover.3mf

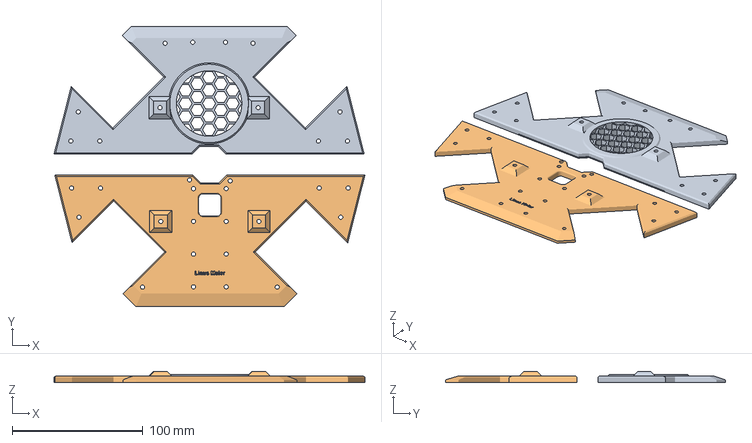
[picture p75: CAD file, 2026-03-23]
cad/sliced_files/Body/Sliced/back cover.3mf
237.7 x 214.3 x 8.50 mm
back cover.step
front cover.step
