Jiggolino/Hexapod/cad/sliced_files/LEG_Final/Sliced/Middle Leg Front.3mf

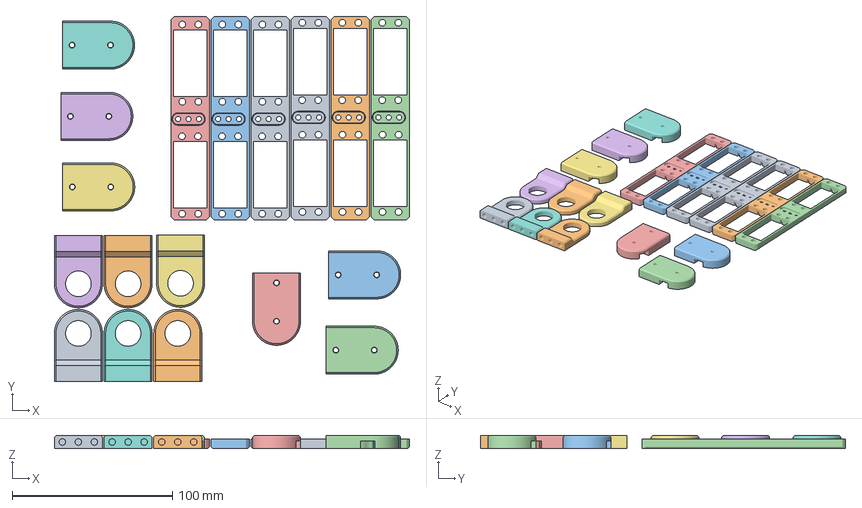
[picture p76: CAD file, 2026-03-23]
cad/sliced_files/LEG_Final/Sliced/Middle Leg Front.3mf
221.7 x 227.8 x 8.00 mm
Middle Leg Front.step x 6
Upper Leg lower hoop left.step x 6
Upper Leg lower hoop right.step x 6
