Jiggolino/Hexapod/cad/sliced_files/LEG_Final/Upper Leg upper hoop bottom.step

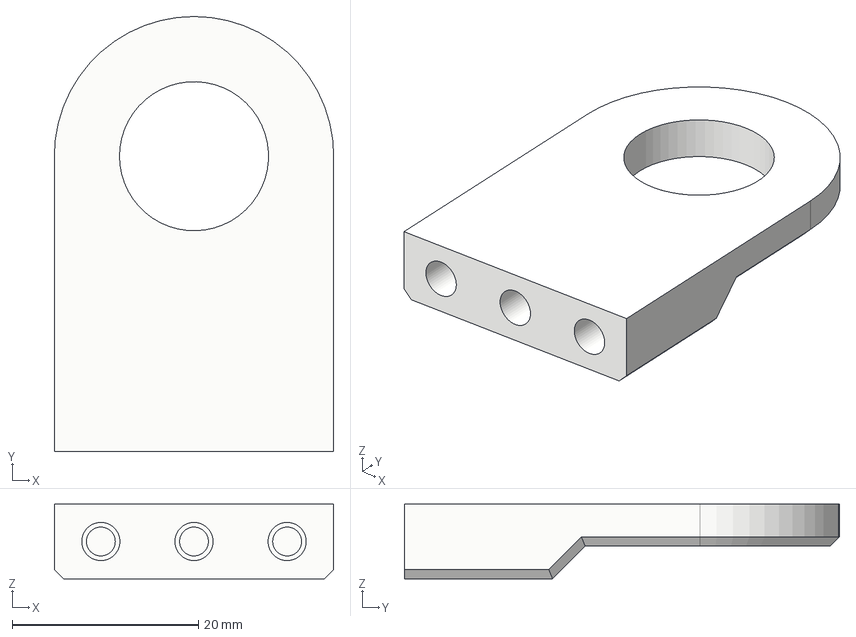
[picture p77: CAD file, 2026-04-13]
cad/sliced_files/LEG_Final/Upper Leg upper hoop bottom.step
30.0 x 46.7 x 8.00 mm
