Jiggolino/Hexapod/cad/sliced_files/Body/Sliced/IO Shield.3mf

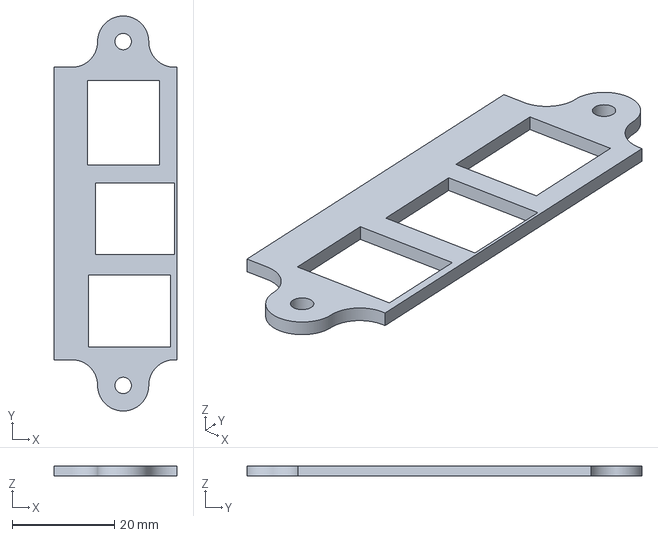
[picture p78: CAD file, 2026-03-23]
cad/sliced_files/Body/Sliced/IO Shield.3mf
24.0 x 77.1 x 2.00 mm
