Jiggolino/Hexapod/cad/sliced_files/LEG_Final/Conector.step

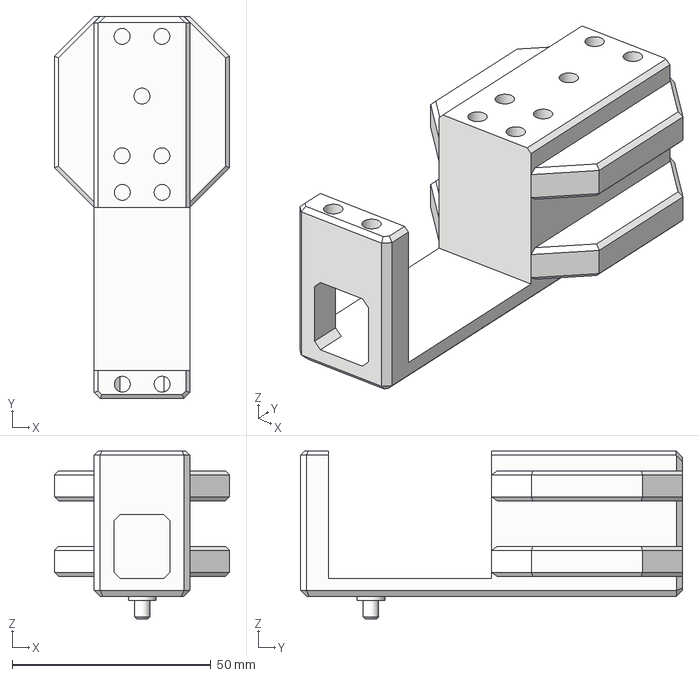
[picture p80: CAD file, 2026-04-13]
cad/sliced_files/LEG_Final/Conector.step
44.0 x 96.0 x 42.2 mm
