Jiggolino/Hexapod/cad/sliced_files/LEG_Final/Lower Leg hoop left.step

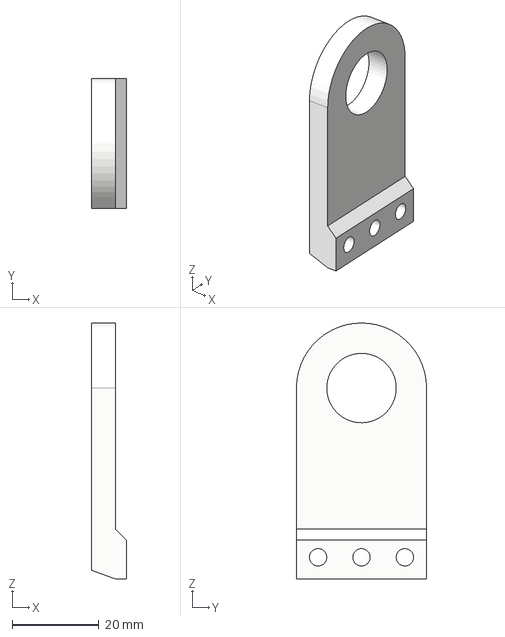
[picture p82: CAD file, 2026-04-13]
cad/sliced_files/LEG_Final/Lower Leg hoop left.step
8.00 x 30.0 x 59.0 mm
