Jiggolino/Hexapod/(list of files, cad)

Other CAD files:
cad/exported_stl_step_files/LegV3/Lower Leg.stl
code/URDF/Hexapod_clean_description/meshes/R4_MIDDLE_1.stl
PCB/powerstrip_left/Footprints/LIB_GMR50HJAAFD5L00/GMR50HJAAFD5L00/3D/GMR50HJAAFD5L00.stp
PCB/powerstrip_left/Footprints/XT60PW-M--3DModel-STEP-269445.STEP
PCB/powerstrip_left/Footprints/XT60PW-M/XT60PW-M.step
PCB/powerstrip_right/Footprints/LIB_GMR50HJAAFD5L00/GMR50HJAAFD5L00/3D/GMR50HJAAFD5L00.stp
PCB/powerstrip_right/Footprints/XT60PW-M--3DModel-STEP-269445.STEP
PCB/powerstrip_right/Footprints/XT60PW-M/XT60PW-M.step
PCB/powerstrip_right/powerstrip_right.step
code/URDF/Hexapod_clean_description/meshes/R6_FRONT_1.stl
code/URDF/Hexapod_clean_description/meshes/R8_MIDDLE_1.stl
code/URDF/Hexapod_clean_description/meshes/L9_FRONT_1.stl
code/URDF/Hexapod_clean_description/meshes/L3_FORNT_1.stl
cad/sliced_files/Body/Sliced/extention cover.3mf
code/URDF/Hexapod_clean_description/meshes/L4_MIDDLE_1.stl
code/URDF/Hexapod_clean_description/meshes/L5_CONNECTOR_1.stl
code/URDF/Hexapod_clean_description/meshes/L1_CONNECTOR_1.stl
code/URDF/Hexapod_clean_description/meshes/L2_MIDDLE_1.stl
code/URDF/Hexapod_clean_description/meshes/L7_CONNECTOR_1.stl
code/URDF/Hexapod_clean_description/meshes/R9_FRONT_1.stl
code/URDF/Hexapod_clean_description/meshes/R5_CONNECTOR_1.stl
code/URDF/Hexapod_clean_description/meshes/R3_FRONT_1.stl
code/URDF/Hexapod_clean_description/meshes/R2_MIDDLE_1.stl
code/URDF/Hexapod_clean_description/meshes/R7_CONNECTOR_1.stl
code/URDF/Hexapod_clean_description/meshes/L6_FRONT_1.stl
code/URDF/Hexapod_clean_description/meshes/base_link.stl
code/URDF/Hexapod_clean_description/meshes/R1_CONNECTOR_1.stl
code/URDF/Hexapod_clean_description/meshes/L8_MIDDLE_1.stl
PCB/powerstrip_left/Footprints/LIB_GMR50HJAAFD5L00/GMR50HJAAFD5L00/Allegro/gmr50hjaafd5l00.psm
PCB/powerstrip_left/Footprints/LIB_GMR50HJAAFD5L00/GMR50HJAAFD5L00/DEHDL/gmr50hjaafd5l00/chips/chips.prt
PCB/powerstrip_left/Footprints/LIB_PCA9685PW_Q900,118/PCA9685PW_Q900,118/Allegro/sop65p640x110-28n.psm
PCB/powerstrip_left/Footprints/LIB_PCA9685PW_Q900,118/PCA9685PW_Q900,118/DEHDL/pca9685pw_q900_118/chips/chips.prt
PCB/powerstrip_left/LIB_150060GS75000/150060GS75000/3D/150060GS75000.stp
PCB/powerstrip_left/LIB_150060GS75000/150060GS75000/Allegro/ledc1608x70n.psm
PCB/powerstrip_left/LIB_150060GS75000/150060GS75000/DEHDL/150060gs75000/chips/chips.prt
PCB/powerstrip_left/LIB_1735265-8/1735265-8/3D/1735265-8.stp
PCB/powerstrip_left/LIB_1735265-8/1735265-8/Allegro/17352658.psm
PCB/powerstrip_left/LIB_1735265-8/1735265-8/DEHDL/1735265_8/chips/chips.prt
PCB/powerstrip_right/Footprints/LIB_150060GS75000/150060GS75000/3D/150060GS75000.stp
PCB/powerstrip_right/Footprints/LIB_150060GS75000/150060GS75000/Allegro/ledc1608x70n.psm
PCB/powerstrip_right/Footprints/LIB_150060GS75000/150060GS75000/DEHDL/150060gs75000/chips/chips.prt
PCB/powerstrip_right/Footprints/LIB_1735265-8/1735265-8/3D/1735265-8.stp
PCB/powerstrip_right/Footprints/LIB_1735265-8/1735265-8/Allegro/17352658.psm
PCB/powerstrip_right/Footprints/LIB_1735265-8/1735265-8/DEHDL/1735265_8/chips/chips.prt
PCB/powerstrip_right/Footprints/LIB_GMR50HJAAFD5L00/GMR50HJAAFD5L00/Allegro/gmr50hjaafd5l00.psm
PCB/powerstrip_right/Footprints/LIB_GMR50HJAAFD5L00/GMR50HJAAFD5L00/DEHDL/gmr50hjaafd5l00/chips/chips.prt
PCB/powerstrip_right/Footprints/LIB_PCA9685PW_Q900,118/PCA9685PW_Q900,118/Allegro/sop65p640x110-28n.psm
PCB/powerstrip_right/Footprints/LIB_PCA9685PW_Q900,118/PCA9685PW_Q900,118/DEHDL/pca9685pw_q900_118/chips/chips.prt
cad/blender_projects/assets/materials/black-leather_11f1bfcf-df46-4097-b229-29c078ef7f6c/black-leather_2K_936a3018-702d-4e89-a0ae-34bb6092106c.blend
cad/blender_projects/assets/materials/black-plastic_5d077501-2739-44eb-8ed7-a99897d95238/black-plastic_2K_d53818b9-7dfc-4b44-ac51-068fa59820db.blend
cad/blender_projects/assets/materials/brushed-black-me_fce84036-4f5c-439d-84ff-904addba32f3/brushed-black-metal-brass_2K_2069e5a0-b3c3-43d9-b40a-29ddc8c23564.blend
cad/blender_projects/assets/materials/cardboard-gray_ac107f93-9dc4-4871-a6b8-1ff97fce7c59/cardboard-gray_2K_ecf33fe5-6249-4675-a85f-f4c4407488a3.blend
cad/blender_projects/assets/materials/clean-silver-shi_dab609e4-8a72-4369-adaa-f0f97b81cf89/clean-silver-shiny-metal_1K_61db0efe-8347-4914-92d6-fc525261b071.blend
cad/blender_projects/assets/materials/metallic-gold_31d586a0-9077-4f19-ba70-e7b8c82859d5/metallic-gold_2K_0a60994f-4b44-469c-9cda-83adf4e06a8a.blend
cad/blender_projects/assets/materials/old-gold_c8f66088-29fe-4fb9-a2a7-869bf351a703/old-gold_2K_70edb793-f8a4-4732-b74d-adbbb0e4b0b6.blend
cad/blender_projects/assets/materials/procedural-pearl_089b11ba-3af0-4daf-a3eb-4e223d63ec6a/procedural-pearl-gray-painted-plastic_a85afd98-6168-4113-9b52-841fba998fa5.blend
cad/blender_projects/assets/materials/procedural-pearl_386d3d08-9144-4145-881e-4b2d25c8202e/procedural-pearl-black-painted-plastic_1259bd7e-0b5d-4e1f-b9a1-3f4d8cb0f768.blend
cad/blender_projects/assets/materials/white-plaster_f7bfbec6-00e2-4b34-9987-64a5aa3b1c62/white-plaster_2K_d66608e4-31df-4b15-b06d-4e9fb90ce4ab.blend
cad/blender_projects/assets/materials/white-plastic_e7ec0db5-ed39-42d5-a2ab-46166e05293c/white-plastic_2K_55554620-1413-4c1a-b06e-7502f5328d0f.blend
cad/blender_projects/assets/materials/white-stone_9eaefae9-e7fe-45ff-867d-2920ec2c3c25/white-stone_2K_602e6d2d-a9a8-413a-ab86-ab484daf8e83.blend
cad/blender_projects/assets/scenes/perfume-render-p_86b701d3-8833-48a0-84fd-8e60a86d7c50/perfume-render-product-visualization_74bc18b9-2b6d-4e0c-8623-c2218182ea56.blend
cad/exported_stl_step_files/LegV1/Conector.step
cad/exported_stl_step_files/LegV1/Foot.step
cad/exported_stl_step_files/LegV1/Lower Leg hoop left.step
cad/exported_stl_step_files/LegV1/Lower Leg hoop right.step
cad/exported_stl_step_files/LegV1/Middle Leg Back.step
cad/exported_stl_step_files/LegV1/Middle Leg Front.step
cad/exported_stl_step_files/LegV1/Upper Leg conector.step
cad/exported_stl_step_files/LegV1/Upper Leg lower hoop left.step
cad/exported_stl_step_files/LegV1/Upper Leg lower hoop right.step
cad/exported_stl_step_files/LegV1/Upper Leg upper hoop bottom.step
cad/exported_stl_step_files/LegV1/Upper Leg upper hoop top.step
cad/exported_stl_step_files/LegV2/Conector.step
cad/exported_stl_step_files/LegV2/Foot.step
cad/exported_stl_step_files/LegV2/Lower Leg hoop left.step
cad/exported_stl_step_files/LegV2/Lower Leg hoop right.step
cad/exported_stl_step_files/LegV2/Lower Leg.stl
cad/exported_stl_step_files/LegV2/Middle Leg Back.step
cad/exported_stl_step_files/LegV2/Middle Leg Front.step
cad/exported_stl_step_files/LegV2/Upper Leg conector.step
cad/exported_stl_step_files/LegV2/Upper Leg lower hoop left.step
cad/exported_stl_step_files/LegV2/Upper Leg lower hoop right.step
cad/exported_stl_step_files/LegV2/Upper Leg upper hoop bottom.step
cad/exported_stl_step_files/LegV2/Upper Leg upper hoop top.step
cad/exported_stl_step_files/LegV3/Conector.f3d
cad/exported_stl_step_files/LegV3/Foot.f3d
cad/exported_stl_step_files/LegV3/Lower Leg hoop left.f3d
cad/exported_stl_step_files/LegV3/Lower Leg hoop right.f3d
cad/exported_stl_step_files/LegV3/Middle Leg Back.f3d
cad/exported_stl_step_files/LegV3/Middle Leg Front.f3d
cad/exported_stl_step_files/LegV3/Upper Leg conector.f3d
cad/exported_stl_step_files/LegV3/Upper Leg lower hoop left.f3d
cad/exported_stl_step_files/LegV3/Upper Leg lower hoop right.f3d
cad/exported_stl_step_files/LegV3/Upper Leg upper hoop bottom.f3d
cad/exported_stl_step_files/LegV3/Upper Leg upper hoop top.f3d
cad/fusion_360/Leg V1.f3d
cad/sliced_files/LegV1/Conector.3mf
cad/sliced_files/LegV1/Foot.3mf
cad/sliced_files/LegV1/Lower Leg hoop left and right.3mf
cad/sliced_files/LegV1/Lower Leg.3mf
cad/sliced_files/LegV1/Middle Leg Front and back.3mf
cad/sliced_files/LegV1/Upper Leg all hoops.3mf
cad/sliced_files/LegV1/Upper Leg conector.3mf
