Jiggolino/Hexapod/pi5/setup.txt

gst-launch-1.0 libcamerasrc ! video/x-raw,format=I420,width=1920,height=1080,framerate=30/1 ! x264enc tune=zerolatency bitrate=5000 speed-preset=ultrafast ! rtph264pay config-interval=1 pt=96 ! udpsink host=100.81.63.86 port=5000

gst-launch-1.0 -v udpsrc port=5000 ! "application/x-rtp, payload=96" ! rtph264depay ! h264parse ! avdec_h264 ! videoconvert ! autovideosink sync=false
