Jiggolino/Hexapod/cad/exported_stl_step_files/LegV2/README.txt

If you need to export these again, use "Save As Mesh" on the Lower Leg and save it as an stl Binary and not as an step file.
