Jiggolino/Hexapod/time/work_log.xlsx

Total time: | Work Log
113 Stunden
Milestones → | Projekt Start |  |  |  |  |  | TRUE | Freigabe Thema |  |  |  |  |  |  |  |  |  |  |  |  | TRUE | Abgabe Anforderungen/Zeitplan |  |  |  |  |  | TRUE | First prototype leg |  |  |  |  |  |  |  |  |  |  |  |  | TRUE | first finished 3D design |  |  |  |  |  |  |  |  |  |  |  |  | TRUE | final leg
Date→ | 2025-08-28 | 2025-08-29 | 2025-08-30 | 2025-08-31 | 2025-09-01 | 2025-09-02 | 2025-09-03 | 2025-09-04 | 2025-09-05 | 2025-09-06 | 2025-09-07 | 2025-09-08 | 2025-09-09 | 2025-09-10 | 2025-09-11 | 2025-09-12 | 2025-09-13 | 2025-09-14 | 2025-09-15 | 2025-09-16 | 2025-09-17 | 2025-09-18 | 2025-09-19 | 2025-09-20 | 2025-09-21 | 2025-09-22 | 2025-09-23 | 2025-09-24 | 2025-09-25 | 2025-09-26 | 2025-09-27 | 2025-09-28 | 2025-09-29 | 2025-09-30 | 2025-10-01 | 2025-10-02 | 2025-10-03 | 2025-10-04 | 2025-10-05 | 2025-10-06 | 2025-10-07 | 2025-10-08 | 2025-10-09 | 2025-10-10 | 2025-10-11 | 2025-10-12 | 2025-10-13 | 2025-10-14 | 2025-10-15 | 2025-10-16 | 2025-10-17 | 2025-10-18 | 2025-10-19 | 2025-10-20 | 2025-10-21 | 2025-10-22 | 2025-10-23 | 2025-10-24 | 2025-10-25
Day → | Thursday | Friday | Saturday | Sunday | Monday | Tuesday | Wednesday | Thursday | Friday | Saturday | Sunday | Monday | Tuesday | Wednesday | Thursday | Friday | Saturday | Sunday | Monday | Tuesday | Wednesday | Thursday | Friday | Saturday | Sunday | Monday | Tuesday | Wednesday | Thursday | Friday | Saturday | Sunday | Monday | Tuesday | Wednesday | Thursday | Friday | Saturday | Sunday | Monday | Tuesday | Wednesday | Thursday | Friday | Saturday | Sunday | Monday | Tuesday | Wednesday | Thursday | Friday | Saturday | Sunday | Monday | Tuesday | Wednesday | Thursday | Friday | Saturday
00:00-01:00 | FALSE | FALSE | FALSE | FALSE | FALSE | FALSE | FALSE | FALSE | FALSE | FALSE | FALSE | FALSE | FALSE | FALSE | FALSE | FALSE | FALSE | FALSE | FALSE | FALSE | FALSE | FALSE | FALSE | FALSE | FALSE | FALSE | FALSE | FALSE | FALSE | FALSE | FALSE | FALSE | FALSE | FALSE | FALSE | FALSE | FALSE | FALSE | FALSE | FALSE | FALSE | FALSE | FALSE | FALSE | FALSE | FALSE | FALSE | FALSE | FALSE | FALSE | FALSE | FALSE | FALSE | FALSE | FALSE | FALSE | FALSE | FALSE | FALSE
01:00-02:00 | FALSE | FALSE | FALSE | FALSE | FALSE | FALSE | FALSE | FALSE | FALSE | FALSE | FALSE | FALSE | FALSE | FALSE | FALSE | FALSE | FALSE | FALSE | FALSE | FALSE | FALSE | FALSE | FALSE | FALSE | FALSE | FALSE | FALSE | FALSE | FALSE | FALSE | FALSE | FALSE | FALSE | FALSE | FALSE | FALSE | FALSE | FALSE | FALSE | FALSE | FALSE | FALSE | FALSE | FALSE | FALSE | FALSE | FALSE | FALSE | FALSE | FALSE | FALSE | FALSE | FALSE | FALSE | FALSE | FALSE | FALSE | FALSE | FALSE
02:00-03:00 | FALSE | FALSE | FALSE | FALSE | FALSE | FALSE | FALSE | FALSE | FALSE | FALSE | FALSE | FALSE | FALSE | FALSE | FALSE | FALSE | FALSE | FALSE | FALSE | FALSE | FALSE | FALSE | FALSE | FALSE | FALSE | FALSE | FALSE | FALSE | FALSE | FALSE | FALSE | FALSE | FALSE | FALSE | FALSE | FALSE | FALSE | FALSE | FALSE | FALSE | FALSE | FALSE | FALSE | FALSE | FALSE | FALSE | FALSE | FALSE | FALSE | FALSE | FALSE | FALSE | FALSE | FALSE | FALSE | FALSE | FALSE | FALSE | FALSE
03:00-04:00 | FALSE | FALSE | FALSE | FALSE | FALSE | FALSE | FALSE | FALSE | FALSE | FALSE | FALSE | FALSE | FALSE | FALSE | FALSE | FALSE | FALSE | FALSE | FALSE | FALSE | FALSE | FALSE | FALSE | FALSE | FALSE | FALSE | FALSE | FALSE | FALSE | FALSE | FALSE | FALSE | FALSE | FALSE | FALSE | FALSE | FALSE | FALSE | FALSE | FALSE | FALSE | FALSE | FALSE | FALSE | FALSE | FALSE | FALSE | FALSE | FALSE | FALSE | FALSE | FALSE | FALSE | FALSE | FALSE | FALSE | FALSE | FALSE | FALSE
04:00-05:00 | FALSE | FALSE | FALSE | FALSE | FALSE | FALSE | FALSE | FALSE | FALSE | FALSE | FALSE | FALSE | FALSE | FALSE | FALSE | FALSE | FALSE | FALSE | FALSE | FALSE | FALSE | FALSE | FALSE | FALSE | FALSE | FALSE | FALSE | FALSE | FALSE | FALSE | FALSE | FALSE | FALSE | FALSE | FALSE | FALSE | FALSE | FALSE | FALSE | FALSE | FALSE | FALSE | FALSE | FALSE | FALSE | FALSE | FALSE | FALSE | FALSE | FALSE | FALSE | FALSE | FALSE | FALSE | FALSE | FALSE | FALSE | FALSE | FALSE
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
20:00-21:00 | FALSE | FALSE | FALSE | FALSE | FALSE | FALSE | FALSE | FALSE | FALSE | FALSE | FALSE | FALSE | FALSE | FALSE | FALSE | FALSE | FALSE | FALSE | FALSE | FALSE | FALSE | FALSE | FALSE | FALSE | FALSE | FALSE | FALSE | FALSE | FALSE | FALSE | FALSE | FALSE | FALSE | FALSE | FALSE | FALSE | FALSE | FALSE | FALSE | FALSE | FALSE | FALSE | FALSE | FALSE | FALSE | FALSE | FALSE | FALSE | FALSE | FALSE | FALSE | FALSE | FALSE | FALSE | FALSE | FALSE | FALSE | FALSE | FALSE
21:00-22:00 | FALSE | FALSE | FALSE | FALSE | FALSE | FALSE | FALSE | FALSE | FALSE | FALSE | FALSE | FALSE | FALSE | FALSE | FALSE | FALSE | FALSE | FALSE | FALSE | FALSE | FALSE | FALSE | FALSE | FALSE | FALSE | FALSE | FALSE | FALSE | FALSE | FALSE | FALSE | FALSE | FALSE | FALSE | FALSE | FALSE | FALSE | FALSE | FALSE | FALSE | FALSE | FALSE | FALSE | FALSE | FALSE | FALSE | FALSE | FALSE | FALSE | FALSE | FALSE | FALSE | FALSE | FALSE | FALSE | FALSE | FALSE | FALSE | FALSE
22:00-23:00 | FALSE | FALSE | FALSE | FALSE | FALSE | FALSE | FALSE | FALSE | FALSE | FALSE | FALSE | FALSE | FALSE | FALSE | FALSE | FALSE | FALSE | FALSE | FALSE | FALSE | FALSE | FALSE | FALSE | FALSE | FALSE | FALSE | FALSE | FALSE | FALSE | FALSE | FALSE | FALSE | FALSE | FALSE | FALSE | FALSE | FALSE | FALSE | FALSE | FALSE | FALSE | FALSE | FALSE | FALSE | FALSE | FALSE | FALSE | FALSE | FALSE | FALSE | FALSE | FALSE | FALSE | FALSE | FALSE | FALSE | FALSE | FALSE | FALSE
23:00-00:00 | FALSE | FALSE | FALSE | FALSE | FALSE | FALSE | FALSE | FALSE | FALSE | FALSE | FALSE | FALSE | FALSE | FALSE | FALSE | FALSE | FALSE | FALSE | FALSE | FALSE | FALSE | FALSE | FALSE | FALSE | FALSE | FALSE | FALSE | FALSE | FALSE | FALSE | FALSE | FALSE | FALSE | FALSE | FALSE | FALSE | FALSE | FALSE | FALSE | FALSE | FALSE | FALSE | FALSE | FALSE | FALSE | FALSE | FALSE | FALSE | FALSE | FALSE | FALSE | FALSE | FALSE | FALSE | FALSE | FALSE | FALSE | FALSE | FALSE
What was done: | got the Büp introduction |  |  |  | I made a list of ideas, asked my work firends for advice and chose the Hexapod Project | i made the Hexapod_Themenwahl_250829.pdf, made the github repo and the time plan |  | i got the approval for my Project and in the lessons i mostly helped others | i started with the 3D design and started making first version of the leg, and i chose the correct servos |  |  | i finished my prototyp and then started on makeing a list with all the things i want to be included in the hexapod | i started designing the main body and searched all the other components i want to include |  | I mostly helped others in calss | i started to desing the main Frame of the Hexapod |  |  | i realised, that the designed mainframe wouldent be strong enought and i restarted | i designed the new frame further |  |  | i bought the servos and did organisationl stuff |  |  | i have started to print the prototype | finisched the print and assambled it and corrected the mistakes |  |  | started with the documentation |  |  | finisched the leg V2 and did some organisotional stuff | i printed the new leg design and assambled it |  | fixed a broken servo (not for my project) and helped raphael by giving a KiCad course | organisational stuff |  |  |  |  |  |  |  |  |  |  |  | Finisched 3D design
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
