Jiggolino/Hexapod/time/1_Semester/work_log.xlsx

Total time: | Work Log
281 Stunden
Milestones → | Projekt Start |  |  |  |  |  | TRUE | Freigabe Thema |  |  |  |  |  |  |  |  |  |  |  |  | TRUE | Abgabe Anforderungen/Zeitplan |  |  |  |  |  | TRUE | First prototype leg |  |  |  |  |  |  |  |  |  |  |  |  | TRUE | first finished 3D design |  |  |  |  |  |  |  |  |  |  |  |  | TRUE | final leg
Date→ | 2025-08-28 | 2025-08-29 | 2025-08-30 | 2025-08-31 | 2025-09-01 | 2025-09-02 | 2025-09-03 | 2025-09-04 | 2025-09-05 | 2025-09-06 | 2025-09-07 | 2025-09-08 | 2025-09-09 | 2025-09-10 | 2025-09-11 | 2025-09-12 | 2025-09-13 | 2025-09-14 | 2025-09-15 | 2025-09-16 | 2025-09-17 | 2025-09-18 | 2025-09-19 | 2025-09-20 | 2025-09-21 | 2025-09-22 | 2025-09-23 | 2025-09-24 | 2025-09-25 | 2025-09-26 | 2025-09-27 | 2025-09-28 | 2025-09-29 | 2025-09-30 | 2025-10-01 | 2025-10-02 | 2025-10-03 | 2025-10-04 | 2025-10-05 | 2025-10-06 | 2025-10-07 | 2025-10-08 | 2025-10-09 | 2025-10-10 | 2025-10-11 | 2025-10-12 | 2025-10-13 | 2025-10-14 | 2025-10-15 | 2025-10-16 | 2025-10-17 | 2025-10-18 | 2025-10-19 | 2025-10-20 | 2025-10-21 | 2025-10-22 | 2025-10-23 | 2025-10-24 | 2025-10-25
Day → | Thursday | Friday | Saturday | Sunday | Monday | Tuesday | Wednesday | Thursday | Friday | Saturday | Sunday | Monday | Tuesday | Wednesday | Thursday | Friday | Saturday | Sunday | Monday | Tuesday | Wednesday | Thursday | Friday | Saturday | Sunday | Monday | Tuesday | Wednesday | Thursday | Friday | Saturday | Sunday | Monday | Tuesday | Wednesday | Thursday | Friday | Saturday | Sunday | Monday | Tuesday | Wednesday | Thursday | Friday | Saturday | Sunday | Monday | Tuesday | Wednesday | Thursday | Friday | Saturday | Sunday | Monday | Tuesday | Wednesday | Thursday | Friday | Saturday
00:00-01:00 | FALSE | FALSE | FALSE | FALSE | FALSE | FALSE | FALSE | FALSE | FALSE | FALSE | FALSE | FALSE | FALSE | FALSE | FALSE | FALSE | FALSE | FALSE | FALSE | FALSE | FALSE | FALSE | FALSE | FALSE | FALSE | FALSE | FALSE | FALSE | FALSE | FALSE | FALSE | FALSE | FALSE | FALSE | FALSE | FALSE | FALSE | FALSE | FALSE | FALSE | FALSE | FALSE | FALSE | FALSE | FALSE | FALSE | FALSE | FALSE | FALSE | FALSE | FALSE | FALSE | FALSE | FALSE | FALSE | FALSE | FALSE | FALSE | FALSE
01:00-02:00 | FALSE | FALSE | FALSE | FALSE | FALSE | FALSE | FALSE | FALSE | FALSE | FALSE | FALSE | FALSE | FALSE | FALSE | FALSE | FALSE | FALSE | FALSE | FALSE | FALSE | FALSE | FALSE | FALSE | FALSE | FALSE | FALSE | FALSE | FALSE | FALSE | FALSE | FALSE | FALSE | FALSE | FALSE | FALSE | FALSE | FALSE | FALSE | FALSE | FALSE | FALSE | FALSE | FALSE | FALSE | FALSE | FALSE | FALSE | FALSE | FALSE | FALSE | FALSE | FALSE | FALSE | FALSE | FALSE | FALSE | FALSE | FALSE | FALSE
02:00-03:00 | FALSE | FALSE | FALSE | FALSE | FALSE | FALSE | FALSE | FALSE | FALSE | FALSE | FALSE | FALSE | FALSE | FALSE | FALSE | FALSE | FALSE | FALSE | FALSE | FALSE | FALSE | FALSE | FALSE | FALSE | FALSE | FALSE | FALSE | FALSE | FALSE | FALSE | FALSE | FALSE | FALSE | FALSE | FALSE | FALSE | FALSE | FALSE | FALSE | FALSE | FALSE | FALSE | FALSE | FALSE | FALSE | FALSE | FALSE | FALSE | FALSE | FALSE | FALSE | FALSE | FALSE | FALSE | FALSE | FALSE | FALSE | FALSE | FALSE
03:00-04:00 | FALSE | FALSE | FALSE | FALSE | FALSE | FALSE | FALSE | FALSE | FALSE | FALSE | FALSE | FALSE | FALSE | FALSE | FALSE | FALSE | FALSE | FALSE | FALSE | FALSE | FALSE | FALSE | FALSE | FALSE | FALSE | FALSE | FALSE | FALSE | FALSE | FALSE | FALSE | FALSE | FALSE | FALSE | FALSE | FALSE | FALSE | FALSE | FALSE | FALSE | FALSE | FALSE | FALSE | FALSE | FALSE | FALSE | FALSE | FALSE | FALSE | FALSE | FALSE | FALSE | FALSE | FALSE | FALSE | FALSE | FALSE | FALSE | FALSE
04:00-05:00 | FALSE | FALSE | FALSE | FALSE | FALSE | FALSE | FALSE | FALSE | FALSE | FALSE | FALSE | FALSE | FALSE | FALSE | FALSE | FALSE | FALSE | FALSE | FALSE | FALSE | FALSE | FALSE | FALSE | FALSE | FALSE | FALSE | FALSE | FALSE | FALSE | FALSE | FALSE | FALSE | FALSE | FALSE | FALSE | FALSE | FALSE | FALSE | FALSE | FALSE | FALSE | FALSE | FALSE | FALSE | FALSE | FALSE | FALSE | FALSE | FALSE | FALSE | FALSE | FALSE | FALSE | FALSE | FALSE | FALSE | FALSE | FALSE | FALSE
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
20:00-21:00 | FALSE | FALSE | FALSE | FALSE | FALSE | FALSE | FALSE | FALSE | FALSE | FALSE | FALSE | FALSE | FALSE | FALSE | FALSE | FALSE | FALSE | FALSE | FALSE | FALSE | FALSE | FALSE | FALSE | FALSE | FALSE | FALSE | FALSE | FALSE | FALSE | FALSE | FALSE | FALSE | FALSE | FALSE | FALSE | FALSE | FALSE | FALSE | FALSE | FALSE | FALSE | FALSE | FALSE | FALSE | FALSE | FALSE | FALSE | FALSE | FALSE | FALSE | FALSE | FALSE | FALSE | FALSE | FALSE | FALSE | FALSE | FALSE | FALSE
21:00-22:00 | FALSE | FALSE | FALSE | FALSE | FALSE | FALSE | FALSE | FALSE | FALSE | FALSE | FALSE | FALSE | FALSE | FALSE | FALSE | FALSE | FALSE | FALSE | FALSE | FALSE | FALSE | FALSE | FALSE | FALSE | FALSE | FALSE | FALSE | FALSE | FALSE | FALSE | FALSE | FALSE | FALSE | FALSE | FALSE | FALSE | FALSE | FALSE | FALSE | FALSE | FALSE | FALSE | FALSE | FALSE | FALSE | FALSE | FALSE | FALSE | FALSE | FALSE | FALSE | FALSE | FALSE | FALSE | FALSE | FALSE | FALSE | FALSE | FALSE
22:00-23:00 | FALSE | FALSE | FALSE | FALSE | FALSE | FALSE | FALSE | FALSE | FALSE | FALSE | FALSE | FALSE | FALSE | FALSE | FALSE | FALSE | FALSE | FALSE | FALSE | FALSE | FALSE | FALSE | FALSE | FALSE | FALSE | FALSE | FALSE | FALSE | FALSE | FALSE | FALSE | FALSE | FALSE | FALSE | FALSE | FALSE | FALSE | FALSE | FALSE | FALSE | FALSE | FALSE | FALSE | FALSE | FALSE | FALSE | FALSE | FALSE | FALSE | FALSE | FALSE | FALSE | FALSE | FALSE | FALSE | FALSE | FALSE | FALSE | FALSE
23:00-00:00 | FALSE | FALSE | FALSE | FALSE | FALSE | FALSE | FALSE | FALSE | FALSE | FALSE | FALSE | FALSE | FALSE | FALSE | FALSE | FALSE | FALSE | FALSE | FALSE | FALSE | FALSE | FALSE | FALSE | FALSE | FALSE | FALSE | FALSE | FALSE | FALSE | FALSE | FALSE | FALSE | FALSE | FALSE | FALSE | FALSE | FALSE | FALSE | FALSE | FALSE | FALSE | FALSE | FALSE | FALSE | FALSE | FALSE | FALSE | FALSE | FALSE | FALSE | FALSE | FALSE | FALSE | FALSE | FALSE | FALSE | FALSE | FALSE | FALSE
What was done: | I've got the BüP introduction |  |  |  | I made a list of ideas, asked my work friends for advice, and chose the Hexapod project | I created the Hexapod_Themenwahl_250829.pdf file, set up the GitHub repo and developed the time plan. |  | I got the approval for my project, and in the lessons I mostly helped others. | I started with the 3D design and began making the first version of the leg, and I chose the correct servos. |  |  | I finished my prototype and then started making a list of all the things I want to be included in the hexapod. | I started designing the main body and researched all the other components I want to include. |  | I mostly helped others in class. | I started to design the main frame of the hexapod. |  |  | I realized that the designed mainframe wouldn't be strong enough, and I restarted. | I continued designing the new frame |  |  | I bought the servos and handled some organizational tasks. |  |  | I started to print the prototype | I finished the print, assembled it, and corrected the mistakes. |  |  | I started with the documentation. |  |  | I finished the leg V2 and handled some organizational tasks. | I printed the new leg design and assembled it. |  | I fixed a broken servo (not for my project) and helped Raphael by giving a KiCad course. | I handled some organizational tasks. |  |  |  |  |  |  |  |  |  |  |  | I finished the 3D design. |  | I 3D printed the final leg and added the heat-set inserts. |  |  | I started with the PCB design. | I finished the power strip PCBs and searched for parts. |  | I helped Nicola. | I started on the mainboard PCB schematic.
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
