Jiggolino/Hexapod/time/2_Semester/work_log.xlsx

Total time: | Work Log
0 Stunden
Milestones → | Projekt Start |  |  |  |  |  | TRUE | Freigabe Thema |  |  |  |  |  |  |  |  |  |  |  |  | TRUE | Abgabe Anforderungen/Zeitplan |  |  |  |  |  | TRUE | First prototype leg |  |  |  |  |  |  |  |  |  |  |  |  | TRUE | first finished 3D design |  |  |  |  |  |  |  |  |  |  |  |  | TRUE | final leg
Date→ | 2026-02-19 | 2026-02-20 | 2026-02-21 | 2026-02-22 | 2026-02-23 | 2026-02-24 | 2026-02-25 | 2026-02-26 | 2026-02-27 | 2026-02-28 | 2026-03-01 | 2026-03-02 | 2026-03-03 | 2026-03-04 | 2026-03-05 | 2026-03-06 | 2026-03-07 | 2026-03-08 | 2026-03-09 | 2026-03-10 | 2026-03-11 | 2026-03-12 | 2026-03-13 | 2026-03-14 | 2026-03-15 | 2026-03-16 | 2026-03-17 | 2026-03-18 | 2026-03-19 | 2026-03-20 | 2026-03-21 | 2026-03-22 | 2026-03-23 | 2026-03-24 | 2026-03-25 | 2026-03-26 | 2026-03-27 | 2026-03-28 | 2026-03-29 | 2026-03-30 | 2026-03-31 | 2026-04-01 | 2026-04-02 | 2026-04-03 | 2026-04-04 | 2026-04-05 | 2026-04-06 | 2026-04-07 | 2026-04-08 | 2026-04-09 | 2026-04-10 | 2026-04-11 | 2026-04-12 | 2026-04-13 | 2026-04-14 | 2026-04-15 | 2026-04-16 | 2026-04-17 | 2026-04-18
Day → | Thursday | Friday | Saturday | Sunday | Monday | Tuesday | Wednesday | Thursday | Friday | Saturday | Sunday | Monday | Tuesday | Wednesday | Thursday | Friday | Saturday | Sunday | Monday | Tuesday | Wednesday | Thursday | Friday | Saturday | Sunday | Monday | Tuesday | Wednesday | Thursday | Friday | Saturday | Sunday | Monday | Tuesday | Wednesday | Thursday | Friday | Saturday | Sunday | Monday | Tuesday | Wednesday | Thursday | Friday | Saturday | Sunday | Monday | Tuesday | Wednesday | Thursday | Friday | Saturday | Sunday | Monday | Tuesday | Wednesday | Thursday | Friday | Saturday
00:00-01:00 | FALSE | FALSE | FALSE | FALSE | FALSE | FALSE | FALSE | FALSE | FALSE | FALSE | FALSE | FALSE | FALSE | FALSE | FALSE | FALSE | FALSE | FALSE | FALSE | FALSE | FALSE | FALSE | FALSE | FALSE | FALSE | FALSE | FALSE | FALSE | FALSE | FALSE | FALSE | FALSE | FALSE | FALSE | FALSE | FALSE | FALSE | FALSE | FALSE | FALSE | FALSE | FALSE | FALSE | FALSE | FALSE | FALSE | FALSE | FALSE | FALSE | FALSE | FALSE | FALSE | FALSE | FALSE | FALSE | FALSE | FALSE | FALSE | FALSE
01:00-02:00 | FALSE | FALSE | FALSE | FALSE | FALSE | FALSE | FALSE | FALSE | FALSE | FALSE | FALSE | FALSE | FALSE | FALSE | FALSE | FALSE | FALSE | FALSE | FALSE | FALSE | FALSE | FALSE | FALSE | FALSE | FALSE | FALSE | FALSE | FALSE | FALSE | FALSE | FALSE | FALSE | FALSE | FALSE | FALSE | FALSE | FALSE | FALSE | FALSE | FALSE | FALSE | FALSE | FALSE | FALSE | FALSE | FALSE | FALSE | FALSE | FALSE | FALSE | FALSE | FALSE | FALSE | FALSE | FALSE | FALSE | FALSE | FALSE | FALSE
02:00-03:00 | FALSE | FALSE | FALSE | FALSE | FALSE | FALSE | FALSE | FALSE | FALSE | FALSE | FALSE | FALSE | FALSE | FALSE | FALSE | FALSE | FALSE | FALSE | FALSE | FALSE | FALSE | FALSE | FALSE | FALSE | FALSE | FALSE | FALSE | FALSE | FALSE | FALSE | FALSE | FALSE | FALSE | FALSE | FALSE | FALSE | FALSE | FALSE | FALSE | FALSE | FALSE | FALSE | FALSE | FALSE | FALSE | FALSE | FALSE | FALSE | FALSE | FALSE | FALSE | FALSE | FALSE | FALSE | FALSE | FALSE | FALSE | FALSE | FALSE
03:00-04:00 | FALSE | FALSE | FALSE | FALSE | FALSE | FALSE | FALSE | FALSE | FALSE | FALSE | FALSE | FALSE | FALSE | FALSE | FALSE | FALSE | FALSE | FALSE | FALSE | FALSE | FALSE | FALSE | FALSE | FALSE | FALSE | FALSE | FALSE | FALSE | FALSE | FALSE | FALSE | FALSE | FALSE | FALSE | FALSE | FALSE | FALSE | FALSE | FALSE | FALSE | FALSE | FALSE | FALSE | FALSE | FALSE | FALSE | FALSE | FALSE | FALSE | FALSE | FALSE | FALSE | FALSE | FALSE | FALSE | FALSE | FALSE | FALSE | FALSE
04:00-05:00 | FALSE | FALSE | FALSE | FALSE | FALSE | FALSE | FALSE | FALSE | FALSE | FALSE | FALSE | FALSE | FALSE | FALSE | FALSE | FALSE | FALSE | FALSE | FALSE | FALSE | FALSE | FALSE | FALSE | FALSE | FALSE | FALSE | FALSE | FALSE | FALSE | FALSE | FALSE | FALSE | FALSE | FALSE | FALSE | FALSE | FALSE | FALSE | FALSE | FALSE | FALSE | FALSE | FALSE | FALSE | FALSE | FALSE | FALSE | FALSE | FALSE | FALSE | FALSE | FALSE | FALSE | FALSE | FALSE | FALSE | FALSE | FALSE | FALSE
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
What was done:
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
