Jiggolino/Hexapod/cad/Hexapod_Servo_Names.pdf

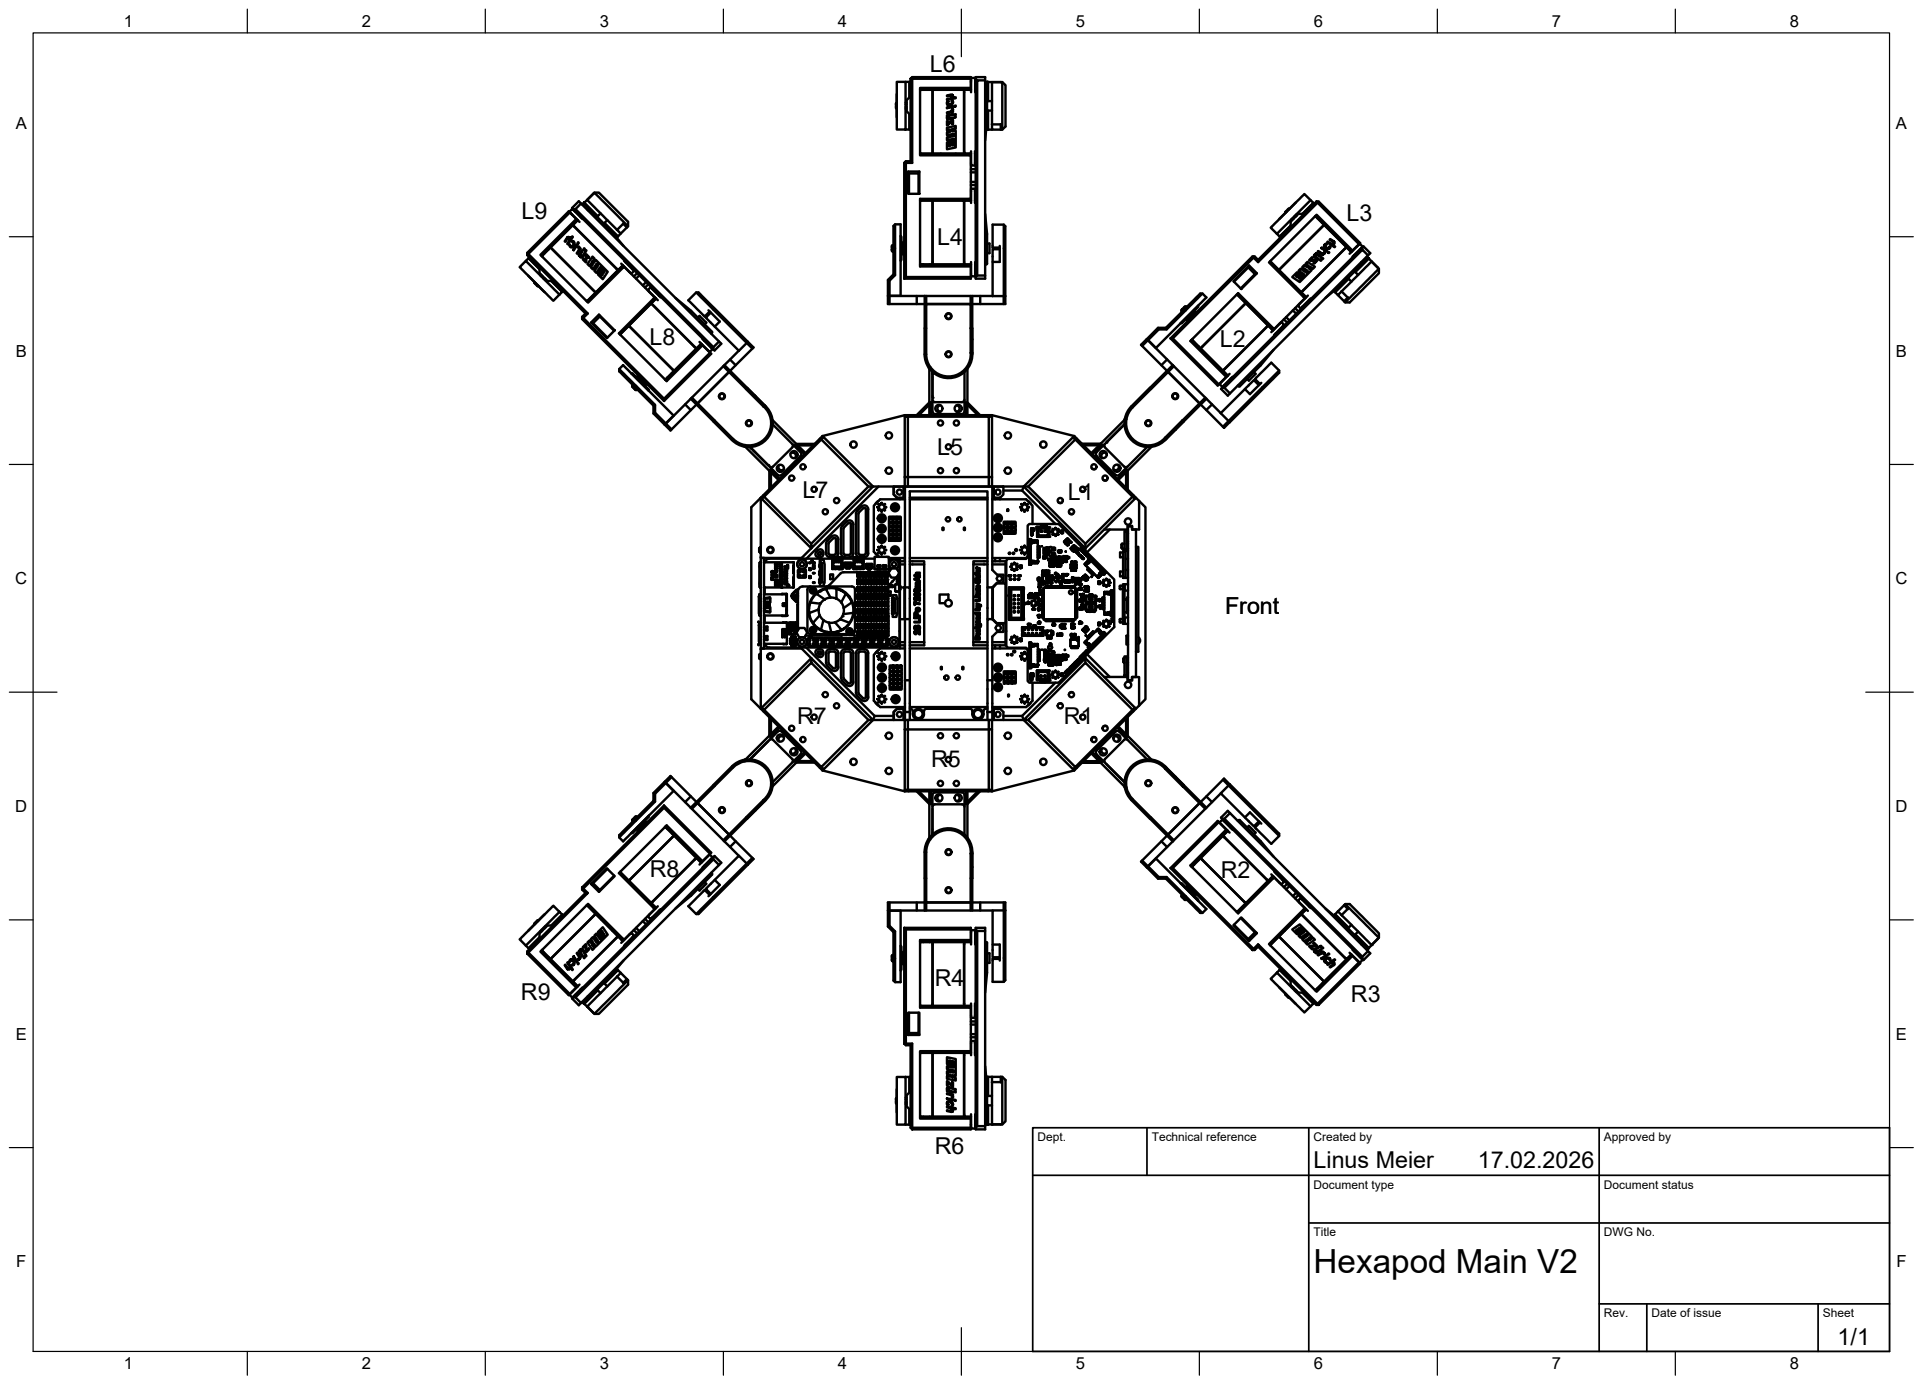
[picture p83: page 1]
