Jiggolino/Hexapod/(list of files, drawings)

Other design files:
PCB/mainboard/freerouting.dsn
PCB/powerstrip_left/Footprints/LIB_PCA9685PW_Q900,118/PCA9685PW_Q900,118/Altium/PCA9685PW_Q900_118.SchLib
PCB/powerstrip_left/Footprints/LIB_PCA9685PW_Q900,118/PCA9685PW_Q900,118/Altium/SOP65P640X110-28N.PcbLib
PCB/powerstrip_left/LIB_150060GS75000/150060GS75000/Altium/150060GS75000.SchLib
PCB/powerstrip_left/LIB_150060GS75000/150060GS75000/Altium/LEDC1608X70N.PcbLib
PCB/powerstrip_left/LIB_1735265-8/1735265-8/Altium/1735265-8.SchLib
PCB/powerstrip_left/LIB_1735265-8/1735265-8/Altium/17352658.PcbLib
PCB/powerstrip_right/Footprints/LIB_150060GS75000/150060GS75000/Altium/150060GS75000.SchLib
PCB/powerstrip_right/Footprints/LIB_150060GS75000/150060GS75000/Altium/LEDC1608X70N.PcbLib
PCB/powerstrip_right/Footprints/LIB_1735265-8/1735265-8/Altium/1735265-8.SchLib
PCB/powerstrip_right/Footprints/LIB_1735265-8/1735265-8/Altium/17352658.PcbLib
PCB/powerstrip_right/Footprints/LIB_PCA9685PW_Q900,118/PCA9685PW_Q900,118/Altium/PCA9685PW_Q900_118.SchLib
PCB/powerstrip_right/Footprints/LIB_PCA9685PW_Q900,118/PCA9685PW_Q900,118/Altium/SOP65P640X110-28N.PcbLib
