Jiggolino/Hexapod/PCB/mainboard/mainboard.kicad_pcb

## KiCad design PCB/mainboard/mainboard.kicad_pcb (2026-04-13)

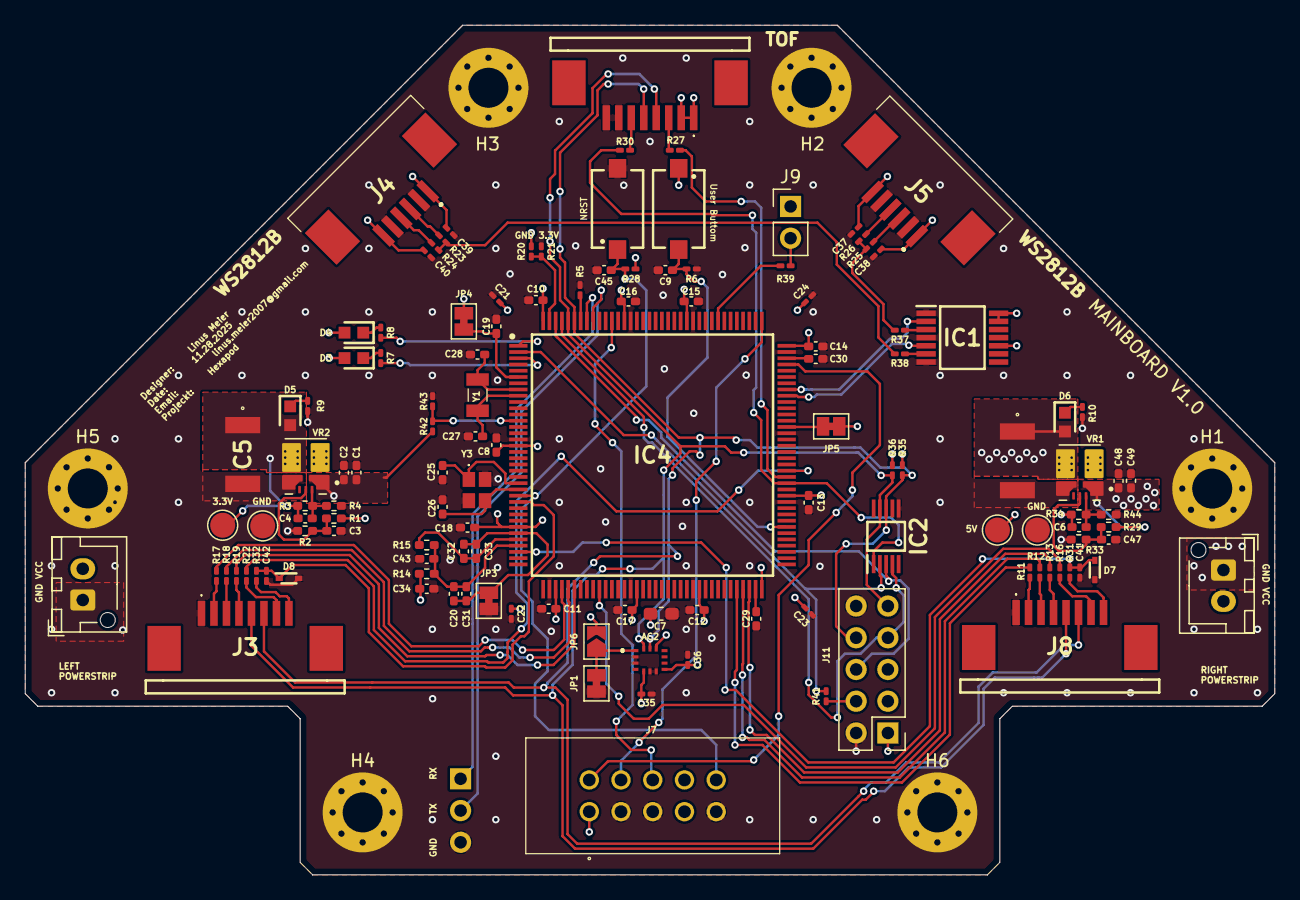
[picture p84: board mainboard.kicad_pcb from above]

Board: 4 copper layers, 100.0 x 68.0 mm, 133 parts (1 on the bottom side), 78 nets.

Parts:
AC2: LSM6DSOTR; LSM6DS3USTR
C1, C49: 10u; C_0402_1005Metric_Pad0.74x0.62mm_HandSolder
C2, C9, C45, C48: 100n; C_0402_1005Metric_Pad0.74x0.62mm_HandSolder
C3, C47: 10n; C_0402_1005Metric_Pad0.74x0.62mm_HandSolder
C4, C6: 22p; C_0402_1005Metric_Pad0.74x0.62mm_HandSolder
C5, C46: 33u; C4532_Commercial
C7: 4.7uF; C_0603_1608Metric_Pad1.08x0.95mm_HandSolder
C8, C10, C11, C12, C13, C14, C15, C16, C17, C18, C31, C33, C34, C43: 100nF; C_0402_1005Metric_Pad0.74x0.62mm_HandSolder
C19, C20, C32: 1uF; C_0402_1005Metric_Pad0.74x0.62mm_HandSolder
C21, C22, C23, C24, C37, C38, C39, C40: 1u; C_0201_0603Metric_Pad0.64x0.40mm_HandSolder
C25, C26: 6pF; C_0402_1005Metric_Pad0.74x0.62mm_HandSolder
C27, C28: 8pF; C_0402_1005Metric_Pad0.74x0.62mm_HandSolder
C29, C30: 2.2u; C_0402_1005Metric_Pad0.74x0.62mm_HandSolder
C35, C36, C41, C42: 100n; C_0201_0603Metric_Pad0.64x0.40mm_HandSolder
D3: LED_Red; LEDC1608X70N
D4, D5, D6: LED_Geen; LEDC1608X70N
D7, D8: BZT585B3V3T-7; SODFL1608X65N
H1, H2, H3, H4, H5, H6: MountingHole_Pad; MountingHole_3.2mm_M3_Pad_Via
IC1: 74HCT125T14-13; SOP65P640X120-14N
IC2: SP4065-08ATG; SOP50P488X110-10N
IC4: STM32H743ZIT6; QFP50P2200X2200X160-144N
J1: Right Strip Power; JST_XH_B2B-XH-AM_1x02_P2.50mm_Vertical
J2: Left Strip Power; JST_XH_B2B-XH-AM_1x02_P2.50mm_Vertical
J3: Left Strip; 17352658
J4: LED Strip left; 849526
J5: LED Strip right; 849526
J6: Time Of Flight; 17352658
J7: TST-105-01-L-D; TST-105-XX-Y-D
J8: Right Strip; 17352658
J9: LED_CAM; PinHeader_1x02_P2.54mm_Vertical
J10: Uart Connector to pi5; PinSocket_1x03_P2.54mm_Vertical
J11: Conn_02x05_Counter_Clockwise; PinHeader_2x05_P2.54mm_Vertical
JP1, JP3, JP4, JP5: SolderJumper_2_Bridged; SolderJumper-2_P1.3mm_Bridged_Pad1.0x1.5mm
JP6: SolderJumper_2_Open; SolderJumper-2_P1.3mm_Open_TrianglePad1.0x1.5mm
R1, R29: 27.4k; R_0402_1005Metric_Pad0.72x0.64mm_HandSolder
R2, R33: 10k; R_0402_1005Metric_Pad0.72x0.64mm_HandSolder
R3: 220k; R_0402_1005Metric_Pad0.72x0.64mm_HandSolder
R4, R44: 30k; R_0402_1005Metric_Pad0.72x0.64mm_HandSolder
R5, R6, R20, R21, R28, R43: 10k; R_0201_0603Metric_Pad0.64x0.40mm_HandSolder
R7, R8, R9, R39: 100R; R_0201_0603Metric_Pad0.64x0.40mm_HandSolder
R10: 270R; R_0201_0603Metric_Pad0.64x0.40mm_HandSolder
R11, R12, R13, R16, R17, R18, R19, R22, R23, R24, R25, R26, R27, R30, R37, R38, R41: 47R; R_0201_0603Metric_Pad0.64x0.40mm_HandSolder
R14, R15: 0R; R_0402_1005Metric_Pad0.72x0.64mm_HandSolder
R31, R32: 10R; R_0201_0603Metric_Pad0.64x0.40mm_HandSolder
R34: 135k; R_0402_1005Metric_Pad0.72x0.64mm_HandSolder
R35, R36: 4.7k; R_0201_0603Metric_Pad0.64x0.40mm_HandSolder
R42: 100k; R_0201_0603Metric_Pad0.64x0.40mm_HandSolder
S1, S4: 434121025816
TP1, TP2, TP3, TP4: TestPoint; TestPoint_Pad_D2.0mm
VR1, VR2: TPSM863252RDXR; VREG_TPSM863252RDXR
Y1: CM7V-T1A-32.768KHZ-7PF-20PPM-TA-QC; CM7V32768TBQA020
Y3: ECS-250-8-36CKM-TR3; ECS250836CKMTR3

Connections:
+3V3: AC2.5 (VDDIO), AC2.8 (VDD), AC2.12 (CS), C4.1, C5.1, C7.1, C8.1, C10.1, C11.1, C12.1, C13.1, C14.1, C15.1, C16.1, C17.1, C18.1, C21.1, C22.1, C23.1, C24.1, C34.1, C35.1, C36.1, D3.2 (A), D4.2 (A), D5.2 (A), IC4.17 (VDD_1), IC4.30 (VDD_2), IC4.39 (VDD_3), IC4.52 (VDD_4), IC4.62 (VDD_5), IC4.72 (VDD_6), IC4.84 (VDD_7), IC4.108 (VDD_8), IC4.121 (VDD_9), IC4.131 (VDD_10), IC4.144 (VDD_11), J6.1, J6.2, J7.1, J9.1, J11.1, JP4.2 (B), JP5.1 (A), JP6.2 (B), R3.1, R14.1, R20.2, R28.2, R35.1, R36.1, S1.1 (COM), TP3.1, VR2.3 (VOUT)
+5V: C6.1, C37.1, C38.1, C39.1, C40.1, C46.1, D6.2 (A), IC1.10 (3~OE), IC1.13 (4~OE), IC1.14 (VCC), J4.1, J4.6, J5.1, J5.6, J11.5, R34.1, TP1.1, VR1.3 (VOUT)
Battery Voltage: IC4.13 (PF3), R42.1, R43.2
Boot0: IC4.138 (BOOT0), R5.2
DIN Board 1: R23.2, R24.2, R38.1
DIN Board 2: R25.2, R26.2, R37.1
DIN WS2812B Board 1 3.3V: IC1.5 (2A), IC4.100 (PA8)
DIN WS2812B Board 2 3.3V: IC1.2 (1A), IC4.101 (PA9)
GND: AC2.2 (SDX), AC2.3 (SCX), AC2.6 (GND_1), AC2.7 (GND_2), C1.2, C2.2, C3.2, C5.2, C7.2, C8.2, C9.1, C10.2, C11.2, C12.2, C13.2, C14.2, C15.2, C16.2, C17.2, C18.2, C19.2, C21.2, C22.2, C23.2, C24.2, C25.1, C26.2, C27.2, C28.2, C29.2, C30.2, C34.2, C35.2, C36.2, C37.2, C38.2, C39.2, C40.2, C41.2, C42.2, C43.2, C45.1, C46.2, C47.2, C48.2, C49.2, D7.2 (A), D8.2 (A), H1.1, H2.1, H3.1, H4.1, H5.1, H6.1, IC1.1 (1~OE), IC1.4 (2~OE), IC1.7 (GND), IC2.6 (GND), IC4.16 (VSS_1), IC4.38 (VSS_2), IC4.51 (VSS_3), IC4.61 (VSS_4), IC4.83 (VSS_5), IC4.94 (VSS_6), IC4.107 (VSS_7), IC4.120 (VSS_8), IC4.130 (VSS_9), J1.1, J2.1, J3.1, J4.2, J4.5, J5.2, J5.5, J6.7, J6.8, J7.3, J7.5, J7.9, J8.1, J10.3, J11.2, J11.10, JP1.1 (A), JP3.1 (A), R2.2, R4.2, R5.1, R6.1, R9.2, R10.2, R21.2, R33.2, R43.1, R44.2, S4.2 (NO), TP2.1, TP4.1, VR1.4 (PGND), VR2.4 (PGND), Y3.2 (GND_1), Y3.4 (GND_2)
GNDA: C20.2, C31.2, C32.2, C33.2, IC4.31 (VSSA), JP3.2 (B)
GPIO 1: IC4.87 (PG2), R27.2
GPIO Expansion 1: IC2.4 (I/O_4), IC4.141 (PE0), J11.7
GPIO Expansion 2: IC2.3 (I/O_3), IC4.142 (PE1), J11.6
GPIO Expansion 3: IC2.2 (I/O_2), IC4.2 (PE3), R41.1
LED_CAM: IC4.116 (PD2), R39.2
NRST: C45.2, IC4.25 (NRST), J7.10, R28.1, S4.1 (COM)
unnamed: AC2.1 (SDO/SA0), JP1.2 (B), JP6.1 (A)
unnamed: D3.1 (K), R7.1
unnamed: D4.1 (K), R8.1
unnamed: D5.1 (K), R9.1
unnamed: D6.1 (K), R10.1
unnamed: IC1.3 (1Y), R37.2
unnamed: IC1.6 (2Y), R38.2
unnamed: J3.2, R17.1
unnamed: J3.3, R18.1
unnamed: J3.4, R19.1
unnamed: J3.7, R22.1
unnamed: J3.8, R32.1
unnamed: J4.3, R23.1
unnamed: J4.4, R24.1
unnamed: J5.3, R25.1
unnamed: J5.4, R26.1
unnamed: J6.3, R27.1
unnamed: J6.6, R30.1
unnamed: J8.2, R11.1
unnamed: J8.3, R12.1
unnamed: J8.4, R13.1
unnamed: J8.7, R16.1
unnamed: J8.8, R31.1
unnamed: J9.2, R39.1
unnamed: J11.4, R41.2
unnamed: C47.1, R29.2, R33.1, VR1.6 (EN)
unnamed: C6.2, R34.2, R44.1, VR1.7 (FB)
unnamed: C3.1, R1.2, R2.1, VR2.6 (EN)
unnamed: C4.2, R3.2, R4.1, VR2.7 (FB)
PC14-OSC32_IN: C28.1, IC4.8 (PC14-OSC32_IN), Y1.1
PC15-OSC32_OUT: C27.1, IC4.9 (PC15-OSC32_OUT), Y1.2
PDR_ON: IC4.143 (PDR_ON), R20.1, R21.1
PE2 (LED): IC4.1 (PE2), R8.2
PE4 (LED): IC4.3 (PE4), R7.2
PH0-OSC_IN: C25.2, IC4.23 (PH0-OSC_IN), Y3.1 (IN/OUT)
PH1-OSC_OUT: C26.1, IC4.24 (PH1-OSC_OUT), Y3.3 (OUT/IN)
RX: IC4.137 (PB7), J10.1
SCL: AC2.13 (SCL), IC2.8 (I/O_6), IC4.139 (PB8), J3.6, J6.5, J8.6, J11.8, R35.2
SDA: AC2.14 (SDA), IC2.9 (I/O_7), IC4.140 (PB9), J3.5, J6.4, J8.5, J11.9, R36.2
SWCLK: IC4.109 (PA14), J7.4
SWDIO: IC4.105 (PA13), J7.2
SWO: IC4.133 (PB3), J7.6
TX: IC4.136 (PB6), J10.2
User Button: C9.2, IC4.79 (PD10), R6.2, S1.2 (NO)
VBAT: C19.1, IC4.6 (VBAT), JP4.1 (A)
VCAP_1: C29.1, IC4.71 (VCAP_1)
VCAP_2: C30.1, IC4.106 (VCAP_2)
VCC: C1.1, C2.1, C48.1, C49.1, J1.2, J2.2, J11.3, R1.1, R29.1, R42.2, VR1.1 (VIN), VR2.1 (VIN)
VDD33_USB: IC4.95 (VDD33USB), JP5.2 (B)
VDDA: C20.1, C31.1, C43.1, IC4.33 (VDDA), R14.2, R15.1
VREFP: C32.1, C33.1, IC4.32 (VREF+), R15.2
XSHUT: IC2.1 (I/O_1), IC4.86 (PD15), R30.2
left_A0: IC4.42 (PA6), R19.2
left_A1: IC4.41 (PA5), R18.2
left_A2: IC4.40 (PA4), R17.2
left_ADC INPUT: C42.1, D8.1 (K), IC4.26 (PC0), R32.2
left_¬EN: IC4.88 (PG3), R22.2
right_A0: IC4.70 (PB11), R13.2
right_A1: IC4.69 (PB10), R12.2
right_A2: IC4.68 (PE15), R11.2
right_ADC INPUT: C41.1, D7.1 (K), IC4.34 (PA0), R31.2
right_¬EN: IC4.46 (PB0), R16.2
