Jiggolino/Hexapod/PCB/powerstrip_right/powerstrip_right.kicad_pcb

## KiCad design PCB/powerstrip_right/powerstrip_right.kicad_pcb (2026-04-13)

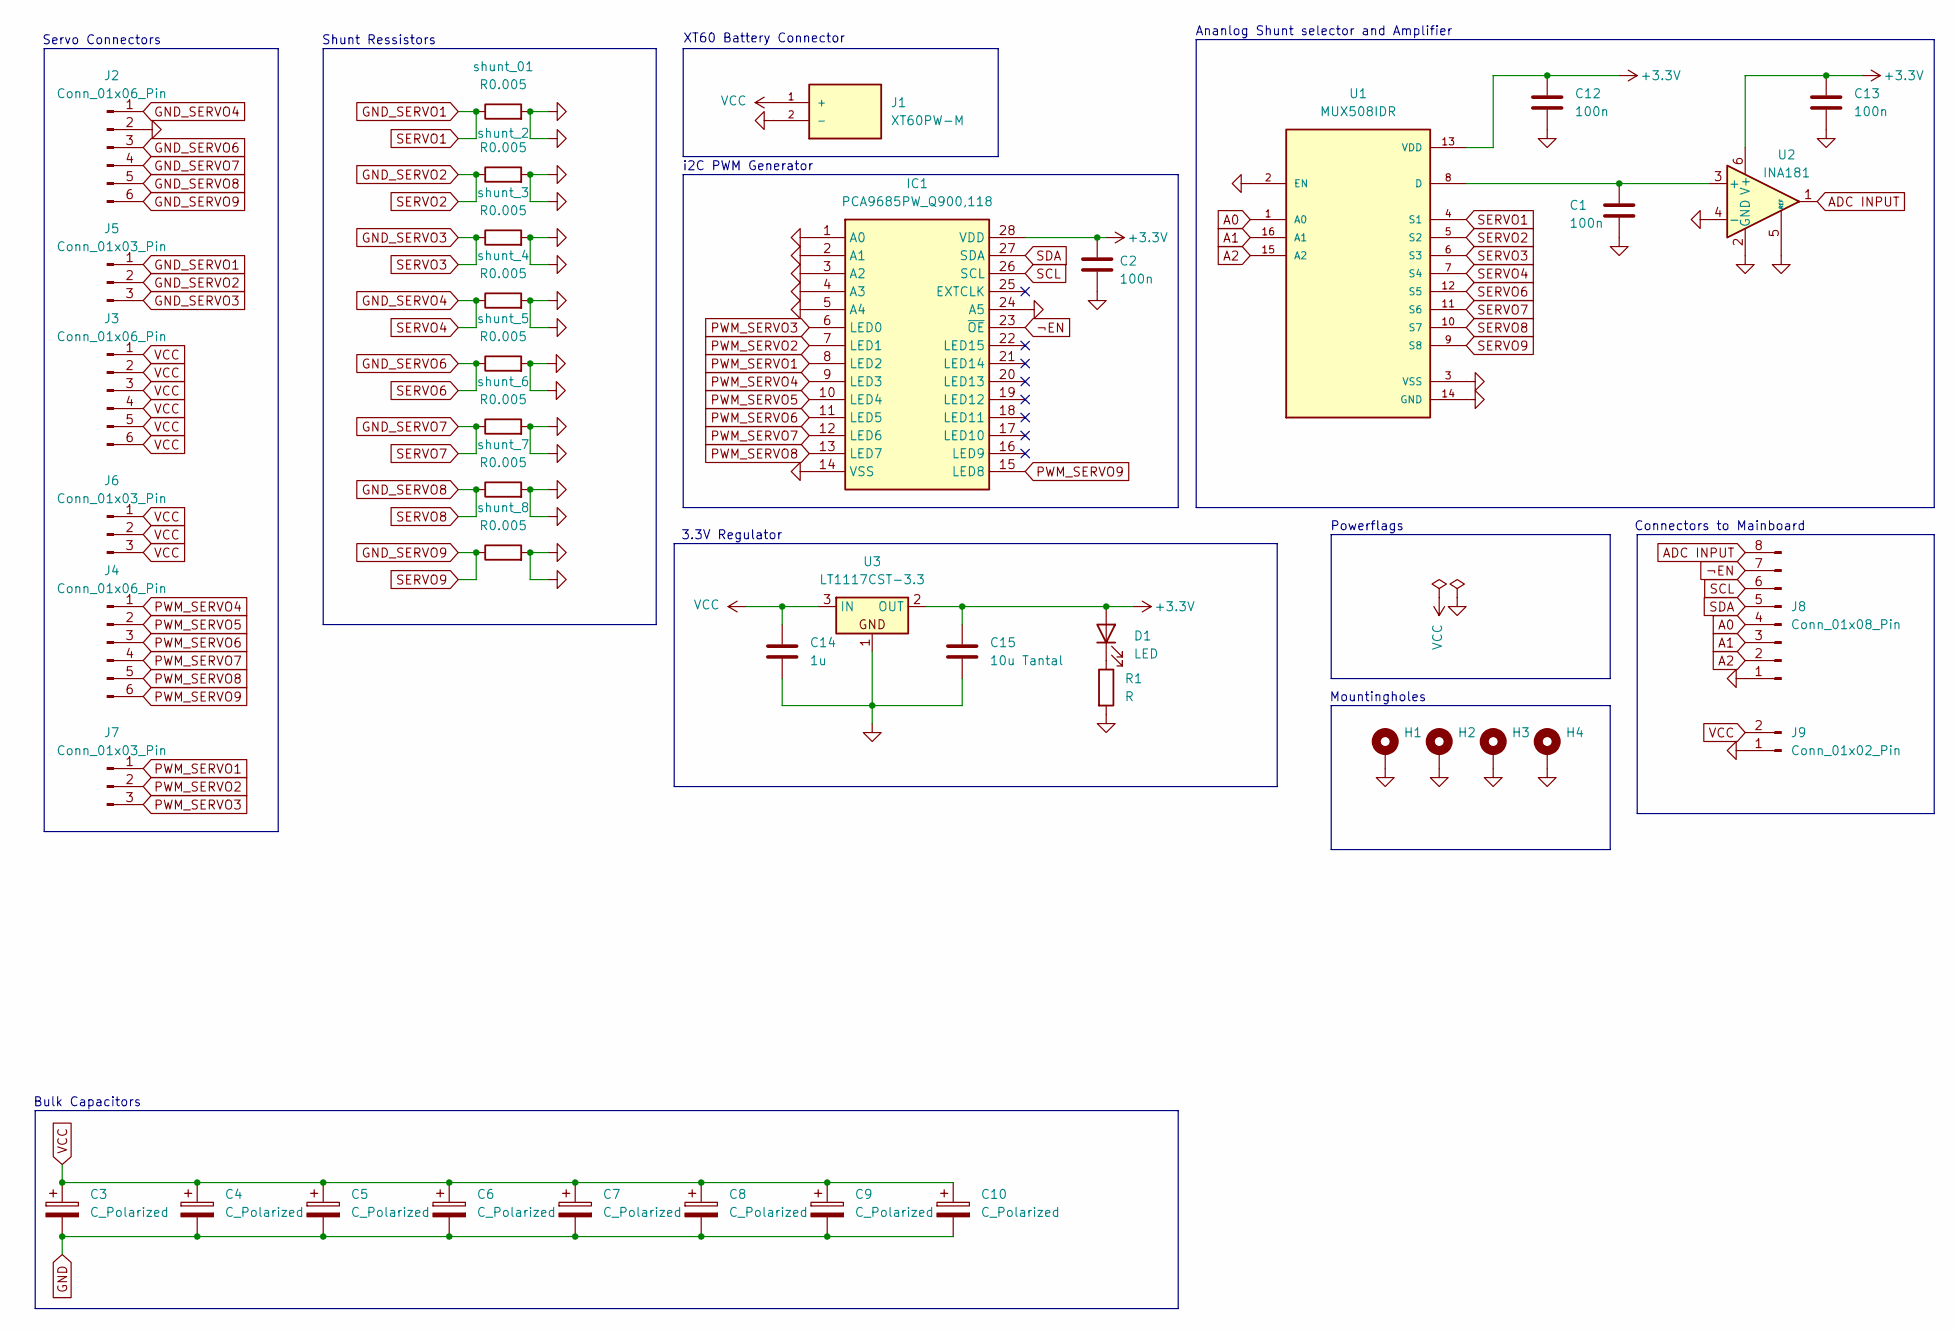
[picture p85: schematic powerstrip_right.kicad_sch]

Parts:
C1, C2, C12, C13: 100n; C_0402_1005Metric_Pad0.74x0.62mm_HandSolder
C3, C4, C5, C6, C7, C8, C9, C10: C_Polarized; CP_Radial_D5.0mm_P2.50mm
C14: 1u; C_1206_3216Metric_Pad1.33x1.80mm_HandSolder
C15: 10u Tantal; C_1206_3216Metric_Pad1.33x1.80mm_HandSolder
D1: LED; LEDC1608X70N
H1, H2, H3, H4: MountingHole_Pad; MountingHole_3.5mm_Pad_Via
IC1: PCA9685PW_Q900,118; SOP65P640X110-28N; Mouser Part Number 771-PCA9685PWQ900118
J1: XT60PW-M; AMASS_XT60PW-M; PARTREV V1.2
J2, J3, J4: Conn_01x06_Pin; PinHeader_1x06_P2.54mm_Vertical
J5, J6, J7: Conn_01x03_Pin; PinHeader_1x03_P2.54mm_Vertical
J8: Conn_01x08_Pin; 17352658
J9: Conn_01x02_Pin; JST_XH_B2B-XH-AM_1x02_P2.50mm_Vertical
R1: R; R_0402_1005Metric_Pad0.72x0.64mm_HandSolder
U1: MUX508IDR; SOIC127P600X175-16N; PARTREV C
U2: INA181; SOT-23-6
U3: LT1117CST-3.3; SOT230P700X180-4N
shunt_01, shunt_2, shunt_3, shunt_4, shunt_5, shunt_6, shunt_7, shunt_8: R0.005; R_1206_3216Metric_Pad1.30x1.75mm_HandSolder

Connections:
+3.3V: C2.1, C12.2, C13.1, C15.1, D1.2 (A), IC1.28 (VDD), U1.13 (VDD), U2.6 (V+), U3.2 (OUT)
A0: J8.4, U1.1 (A0)
A1: J8.3, U1.16 (A1)
A2: J8.2, U1.15 (A2)
ADC INPUT: J8.8, U2.1
GND: C1.2, C2.2, C3.2, C4.2, C5.2, C6.2, C7.2, C8.2, C9.2, C10.2, C12.1, C13.2, C14.2, C15.2, H1.1, H2.1, H3.1, H4.1, IC1.1 (A0), IC1.2 (A1), IC1.3 (A2), IC1.4 (A3), IC1.5 (A4), IC1.14 (VSS), IC1.24 (A5), J1.2 (-), J2.2, J8.1, J9.1, R1.2, U1.2 (EN), U1.3 (VSS), U1.14 (GND), U2.2 (GND), U2.4 (-), U2.5 (REF), U3.1, shunt_01.2, shunt_2.2, shunt_3.2, shunt_4.2, shunt_5.2, shunt_6.2, shunt_7.2, shunt_8.2
GND_SERVO1: J5.1, U1.4 (S1), shunt_01.1
GND_SERVO2: J5.2, U1.5 (S2), shunt_2.1
GND_SERVO3: J5.3, U1.6 (S3), shunt_3.1
GND_SERVO4: J2.1, U1.7 (S4), shunt_4.1
GND_SERVO6: J2.3, U1.12 (S5), shunt_5.1
GND_SERVO7: J2.4, U1.11 (S6), shunt_6.1
GND_SERVO8: J2.5, U1.10 (S7), shunt_7.1
GND_SERVO9: J2.6, U1.9 (S8), shunt_8.1
unnamed: D1.1 (K), R1.1
unnamed: C1.1, U1.8 (D), U2.3 (+)
PWM_SERVO1: IC1.8 (LED2), J7.1
PWM_SERVO2: IC1.7 (LED1), J7.2
PWM_SERVO3: IC1.6 (LED0), J7.3
PWM_SERVO4: IC1.9 (LED3), J4.1
PWM_SERVO5: IC1.10 (LED4), J4.2
PWM_SERVO6: IC1.11 (LED5), J4.3
PWM_SERVO7: IC1.12 (LED6), J4.4
PWM_SERVO8: IC1.13 (LED7), J4.5
PWM_SERVO9: IC1.15 (LED8), J4.6
SCL: IC1.26 (SCL), J8.6
SDA: IC1.27 (SDA), J8.5
VCC: C3.1, C4.1, C5.1, C6.1, C7.1, C8.1, C9.1, C10.1, C14.1, J1.1 (+), J3.1, J3.2, J3.3, J3.4, J3.5, J3.6, J6.1, J6.2, J6.3, J9.2, U3.3 (IN)
¬EN: IC1.23 (~OE), J8.7

Notes on the sheet:
XT60 Battery Connector
3.3V Regulator
Bulk Capacitors
Connectors to Mainboard
Shunt Ressistors
i2C PWM Generator
Servo Connectors
Mountingholes
Ananlog Shunt selector and Amplifier
Powerflags

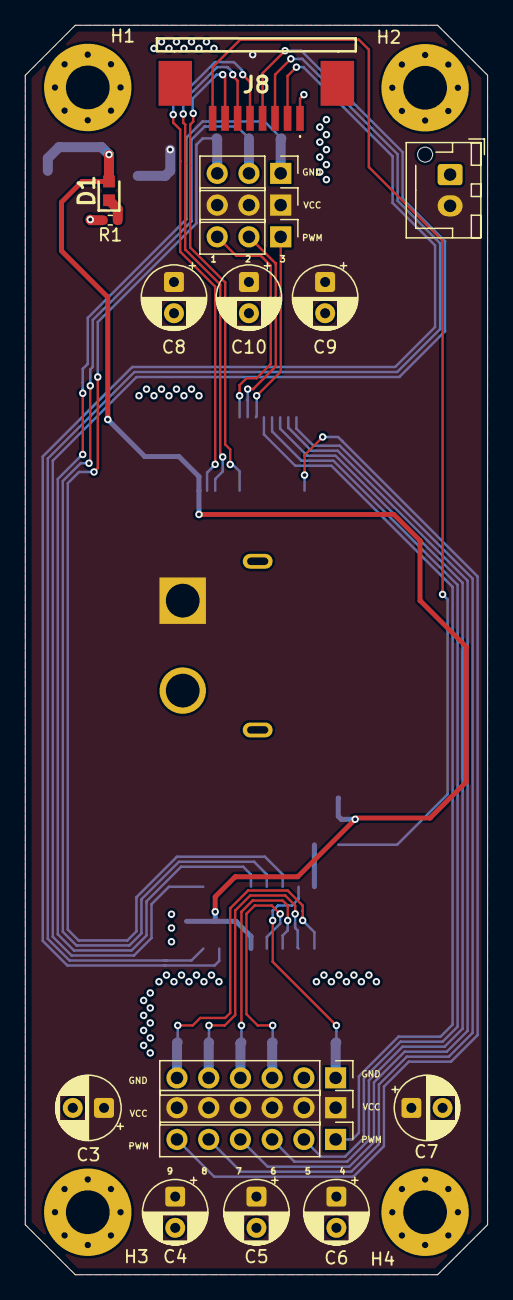
[picture p86: board powerstrip_right.kicad_pcb from above]

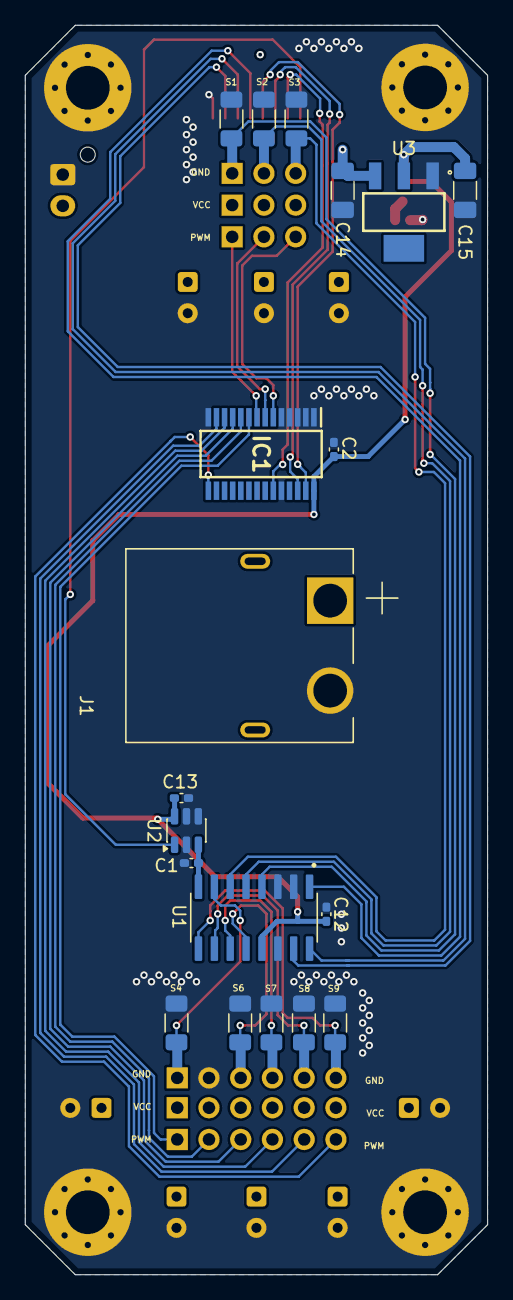
[picture p87: board powerstrip_right.kicad_pcb from below]

Board: 4 copper layers, 37.0 x 100.0 mm, 41 parts (19 on the bottom side), 29 nets.
