Jiggolino/Hexapod/PCB/front/front.kicad_pcb

## KiCad design PCB/front/front.kicad_pcb (2026-04-13)

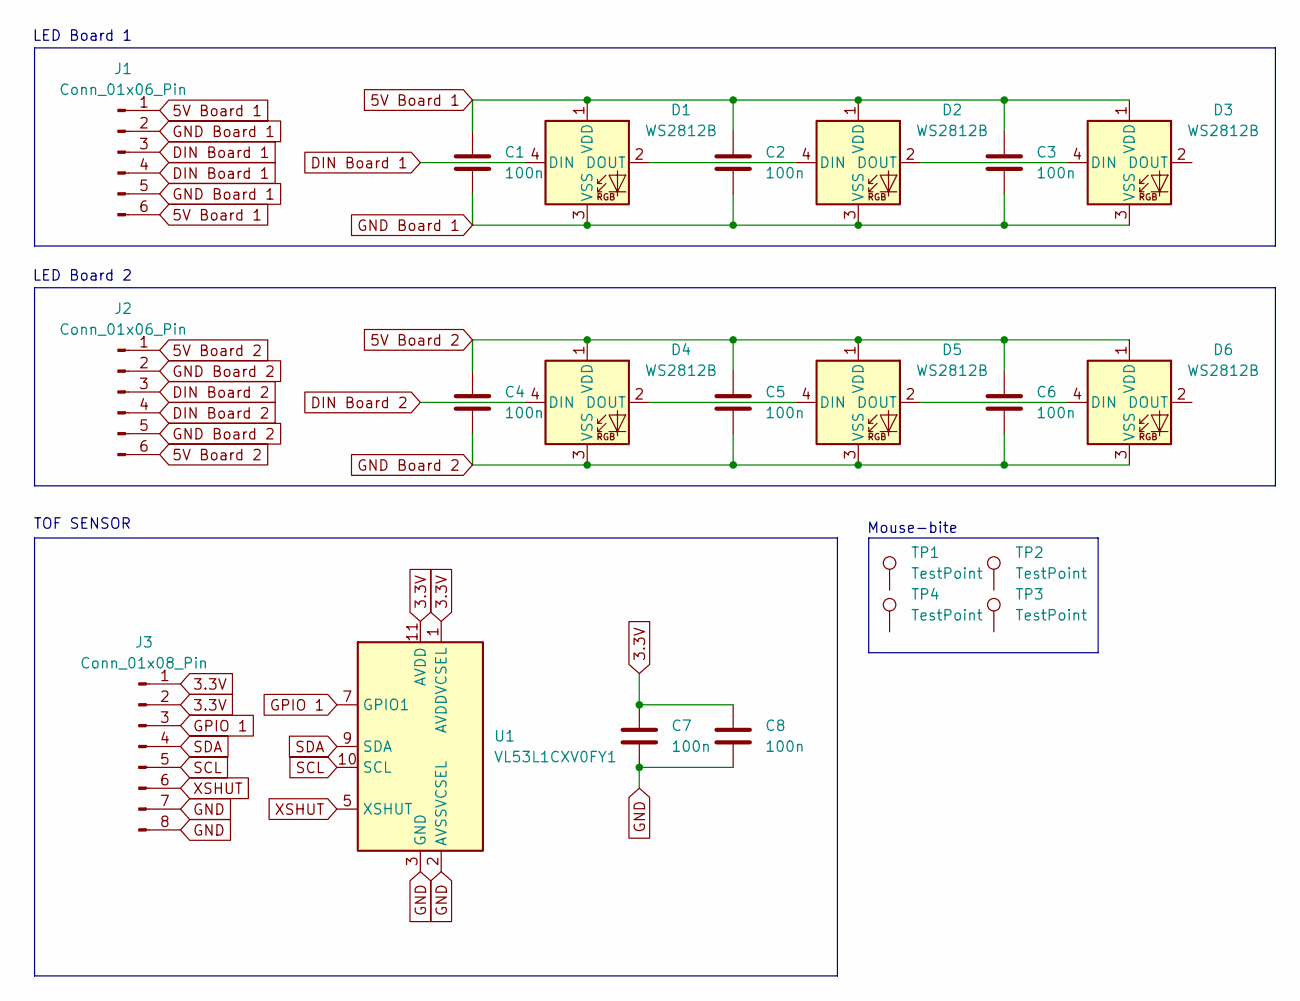
[picture p88: schematic front.kicad_sch]

Parts:
C1, C2, C3, C4, C5, C6, C7, C8: 100n; C_0402_1005Metric_Pad0.74x0.62mm_HandSolder
D1, D2, D3, D4, D5, D6: WS2812B; LED_WS2812B_PLCC4_5.0x5.0mm_P3.2mm
J1, J2: Conn_01x06_Pin; 849526
J3: Conn_01x08_Pin; 17352658
TP1, TP2, TP3, TP4: TestPoint; mouse-bite-1mm-3mm
U1: VL53L1CXV0FY1; ST_VL53L1x

Connections:
3.3V: C7.1, C8.1, J3.1, J3.2, U1.1 (AVDDVCSEL), U1.11 (AVDD)
5V Board 1: C1.1, C2.1, C3.1, D1.1 (VDD), D2.1 (VDD), D3.1 (VDD), J1.1, J1.6
5V Board 2: C4.1, C5.1, C6.1, D4.1 (VDD), D5.1 (VDD), D6.1 (VDD), J2.1, J2.6
DIN Board 1: D1.4 (DIN), J1.3, J1.4
DIN Board 2: D4.4 (DIN), J2.3, J2.4
GND: C7.2, C8.2, J3.7, J3.8, U1.2 (AVSSVCSEL), U1.3 (GND), U1.4 (GND), U1.6 (GND), U1.12 (GND)
GND Board 1: C1.2, C2.2, C3.2, D1.3 (VSS), D2.3 (VSS), D3.3 (VSS), J1.2, J1.5
GND Board 2: C4.2, C5.2, C6.2, D4.3 (VSS), D5.3 (VSS), D6.3 (VSS), J2.2, J2.5
GPIO 1: J3.3, U1.7 (GPIO1)
unnamed: D1.2 (DOUT), D2.4 (DIN)
unnamed: D2.2 (DOUT), D3.4 (DIN)
unnamed: D4.2 (DOUT), D5.4 (DIN)
unnamed: D5.2 (DOUT), D6.4 (DIN)
SCL: J3.5, U1.10 (SCL)
SDA: J3.4, U1.9 (SDA)
XSHUT: J3.6, U1.5 (XSHUT)

Notes on the sheet:
LED Board 2
LED Board 1
TOF SENSOR
Mouse-bite

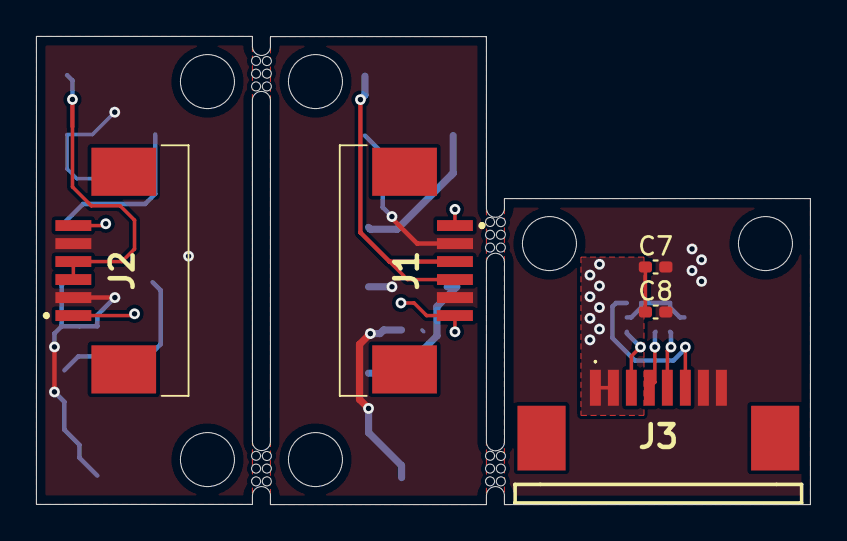
[picture p89: board front.kicad_pcb from above]

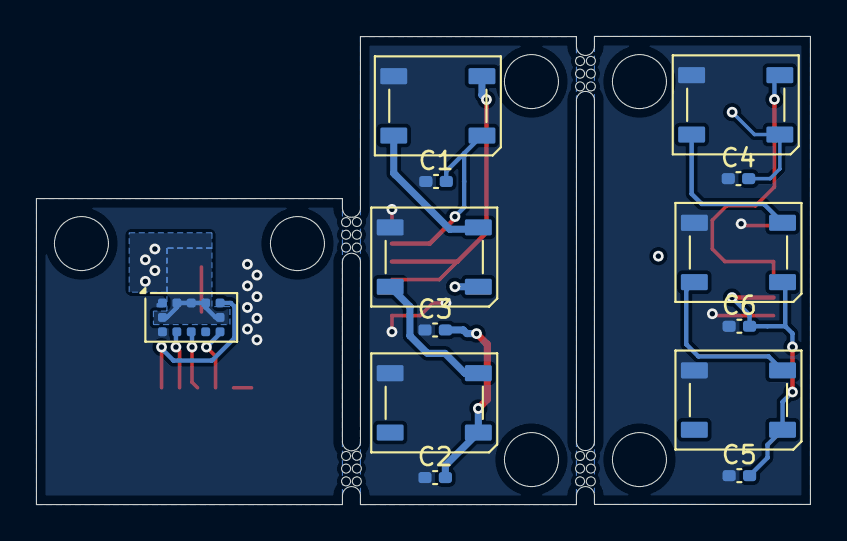
[picture p90: board front.kicad_pcb from below]

Board: 2 copper layers, 43.0 x 26.0 mm, 22 parts (13 on the bottom side), 16 nets.
