Jiggolino/Hexapod/code/URDF/Hexapod_clean_description/launch/controller.yaml

Hexapod_clean_controller:
  # Publish all joint states -----------------------------------
  joint_state_controller:
    type: joint_state_controller/JointStateController
    publish_rate: 50

  # Position Controllers --------------------------------------
  Revolute 57_position_controller:
    type: effort_controllers/JointPositionController
    joint: Revolute 57
    pid: {p: 100.0, i: 0.01, d: 10.0}
  Revolute 58_position_controller:
    type: effort_controllers/JointPositionController
    joint: Revolute 58
    pid: {p: 100.0, i: 0.01, d: 10.0}
  Revolute 59_position_controller:
    type: effort_controllers/JointPositionController
    joint: Revolute 59
    pid: {p: 100.0, i: 0.01, d: 10.0}
  Revolute 60_position_controller:
    type: effort_controllers/JointPositionController
    joint: Revolute 60
    pid: {p: 100.0, i: 0.01, d: 10.0}
  Revolute 61_position_controller:
    type: effort_controllers/JointPositionController
    joint: Revolute 61
    pid: {p: 100.0, i: 0.01, d: 10.0}
  Revolute 62_position_controller:
    type: effort_controllers/JointPositionController
    joint: Revolute 62
    pid: {p: 100.0, i: 0.01, d: 10.0}
  Revolute 63_position_controller:
    type: effort_controllers/JointPositionController
    joint: Revolute 63
    pid: {p: 100.0, i: 0.01, d: 10.0}
  Revolute 64_position_controller:
    type: effort_controllers/JointPositionController
    joint: Revolute 64
    pid: {p: 100.0, i: 0.01, d: 10.0}
  Revolute 65_position_controller:
    type: effort_controllers/JointPositionController
    joint: Revolute 65
    pid: {p: 100.0, i: 0.01, d: 10.0}
  Revolute 66_position_controller:
    type: effort_controllers/JointPositionController
    joint: Revolute 66
    pid: {p: 100.0, i: 0.01, d: 10.0}
  Revolute 67_position_controller:
    type: effort_controllers/JointPositionController
    joint: Revolute 67
    pid: {p: 100.0, i: 0.01, d: 10.0}
  Revolute 68_position_controller:
    type: effort_controllers/JointPositionController
    joint: Revolute 68
    pid: {p: 100.0, i: 0.01, d: 10.0}
  Revolute 69_position_controller:
    type: effort_controllers/JointPositionController
    joint: Revolute 69
    pid: {p: 100.0, i: 0.01, d: 10.0}
  Revolute 70_position_controller:
    type: effort_controllers/JointPositionController
    joint: Revolute 70
    pid: {p: 100.0, i: 0.01, d: 10.0}
  Revolute 71_position_controller:
    type: effort_controllers/JointPositionController
    joint: Revolute 71
    pid: {p: 100.0, i: 0.01, d: 10.0}
  Revolute 72_position_controller:
    type: effort_controllers/JointPositionController
    joint: Revolute 72
    pid: {p: 100.0, i: 0.01, d: 10.0}
  Revolute 73_position_controller:
    type: effort_controllers/JointPositionController
    joint: Revolute 73
    pid: {p: 100.0, i: 0.01, d: 10.0}
  Revolute 74_position_controller:
    type: effort_controllers/JointPositionController
    joint: Revolute 74
    pid: {p: 100.0, i: 0.01, d: 10.0}
