Jiggolino/Hexapod/firmware/Mainboard_code_V1/Core/Src/main.c

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

/* Includes ------------------------------------------------------------------*/
#include "main.h"

/* USER CODE BEGIN Includes */
#include <stdio.h>
#include <string.h>
#include <stdint.h>
#include <ctype.h>
#include "pca9685.h"
#include "imu.h"
#include "tof.h"
/* USER CODE END Includes */

ADC_HandleTypeDef hadc1;
ADC_HandleTypeDef hadc2;
ADC_HandleTypeDef hadc3;
I2C_HandleTypeDef hi2c1;
UART_HandleTypeDef huart1;

/* USER CODE BEGIN PV */
/* Servo Drivers */
static PCA9685_t pca_right;
static PCA9685_t pca_left;

/* IMU */
static stmdev_ctx_t imu_ctx;
static IMU_Data_t   imu_data;

/* ToF */
static TOF_Data_t tof_data;

/* UART receive */
#define CMD_BUF_LEN 32
static char    cmd_buf[CMD_BUF_LEN];
static uint8_t cmd_idx   = 0;
static uint8_t cmd_ready = 0;

/* Sensor streaming */
static uint8_t  stream_on      = 0;
static uint32_t next_stream_ms = 0;
#define STREAM_INTERVAL_MS  100u   /* 10 Hz */
/* USER CODE END PV */

void SystemClock_Config(void);
void PeriphCommonClock_Config(void);
static void MPU_Config(void);
static void MX_GPIO_Init(void);
static void MX_USART1_UART_Init(void);
static void MX_ADC1_Init(void);
static void MX_ADC2_Init(void);
static void MX_ADC3_Init(void);
static void MX_I2C1_Init(void);

/* USER CODE BEGIN PFP */
static void process_command(const char *cmd);
static void center_all_servos(void);
/* USER CODE END PFP */

/* USER CODE BEGIN 0 */

/* SYS-remap to UART */
int _write(int file, char *ptr, int len)
{
    HAL_UART_Transmit(&huart1, (uint8_t *)ptr, len, HAL_MAX_DELAY);
    return len;
}

/* ── UART polling receive — call every main loop iteration ─────────────── */
static void uart_poll(void)
{
    uint8_t byte;
    if (HAL_UART_Receive(&huart1, &byte, 1, 1) != HAL_OK)
        return;   /* no byte within 1 ms */

    char c = (char)byte;

    /* Echo the character back so the user sees what they typed */
    HAL_UART_Transmit(&huart1, &byte, 1, 10);

    if (c == '\r' || c == '\n') {
        /* Echo newline */
        uint8_t crlf[2] = {'\r', '\n'};
        HAL_UART_Transmit(&huart1, crlf, 2, 10);

        if (cmd_idx > 0) {
            cmd_buf[cmd_idx] = '\0';
            cmd_idx   = 0;
            cmd_ready = 1;
        }
    } else if (c == 127 || c == '\b') {
        /* Backspace — remove last char */
        if (cmd_idx > 0) cmd_idx--;
    } else if (cmd_idx < CMD_BUF_LEN - 1) {
        cmd_buf[cmd_idx++] = c;
    }
}

/* ── Command processing ─────────────────────────────────────────────────── */

static void process_command(const char *cmd)
{
    char side;
    int  index;
    float angle;

    /* Convert first char to upper for case-insensitive match */
    char first = (char)toupper((unsigned char)cmd[0]);

    if (first == 'R' || first == 'L') {
        /* Servo command: R<n> <angle>  or  L<n> <angle> */
        if (sscanf(cmd + 1, "%d %f", &index, &angle) == 2) {
            if (index < 1 || index > 9) {
                printf("ERR: servo index must be 1-9\r\n");
                return;
            }
            side = first;
            PCA9685_t *board = (side == 'R') ? &pca_right : &pca_left;
            HAL_StatusTypeDef s = PCA9685_SetServoAngle(board,
                                      (uint8_t)(index - 1), angle);
            if (s == HAL_OK)
                printf("OK: %c%d = %.1f deg\r\n", side, index, angle);
            else
                printf("ERR: I2C failed for %c%d\r\n", side, index);
        } else {
            printf("ERR: format is R<1-9> <0-180>  e.g. R3 90\r\n");
        }

    } else if (strncmp(cmd, "STATUS", 6) == 0 ||
               strncmp(cmd, "status", 6) == 0) {
        IMU_Read(&imu_ctx, &imu_data);
        IMU_Print(&imu_data);
        int8_t got = TOF_Read(&tof_data);
        if (got == 1)
            TOF_Print(&tof_data);
        else
            printf("TOF | no data\r\n");

    } else if (strncmp(cmd, "STREAM", 6) == 0 ||
               strncmp(cmd, "stream", 6) == 0) {
        stream_on = !stream_on;
        printf("STREAM %s\r\n", stream_on ? "ON" : "OFF");

    } else if (strncmp(cmd, "CENTER", 6) == 0 ||
               strncmp(cmd, "center", 6) == 0) {
        center_all_servos();
        printf("OK: all servos centered\r\n");

    } else {
        printf("ERR: unknown command '%s'\r\n", cmd);
        printf("     Valid: R<1-9> <deg>, L<1-9> <deg>, STATUS, STREAM, CENTER\r\n");
    }
}

static void center_all_servos(void)
{
    for (uint8_t ch = 0; ch < 9; ch++) {
    	PCA9685_SetServoAngle(&pca_right, ch, 90.0f);
        PCA9685_SetServoAngle(&pca_left,  ch, 90.0f);
    }
}

/* USER CODE END 0 */

int main(void)
{
    MPU_Config();
    HAL_Init();
    SystemClock_Config();
    PeriphCommonClock_Config();

    MX_GPIO_Init();
    MX_USART1_UART_Init();
    MX_ADC1_Init();
    MX_ADC2_Init();
    MX_ADC3_Init();
    MX_I2C1_Init();

    /* USER CODE BEGIN 2 */
    setvbuf(stdout, NULL, _IONBF, 0);

    printf("\r\n=== Hexapod Mainboard ===\r\n");

    /* ── Enable servo driver OE pins (active-low on your board) ── */
    HAL_GPIO_WritePin(Right_Enable_GPIO_Port, Right_Enable_Pin, GPIO_PIN_RESET);
    HAL_GPIO_WritePin(Left_Enable_GPIO_Port,  Left_Enable_Pin,  GPIO_PIN_RESET);

    /* ── PCA9685 Right ────────────────────────────────────────── */
    pca_right.hi2c   = &hi2c1;
    pca_right.addr   = PCA9685_ADDR_RIGHT;
    pca_right.freq_hz = 50.0f;
    pca_right.min_us = PCA9685_SERVO_MIN_US;
    pca_right.max_us = PCA9685_SERVO_MAX_US;

    if (PCA9685_Init(&pca_right) == HAL_OK)
        printf("PCA9685 Right: OK\r\n");
    else
        printf("PCA9685 Right: FAIL\r\n");

    /* ── PCA9685 Left ─────────────────────────────────────────── */
    pca_left.hi2c   = &hi2c1;
    pca_left.addr   = PCA9685_ADDR_LEFT;
    pca_left.freq_hz = 50.0f;
    pca_left.min_us = PCA9685_SERVO_MIN_US;
    pca_left.max_us = PCA9685_SERVO_MAX_US;

    if (PCA9685_Init(&pca_left) == HAL_OK)
        printf("PCA9685 Left:  OK\r\n");
    else
        printf("PCA9685 Left:  FAIL\r\n");

    /* Center all servos on boot */
    center_all_servos();

    /* ── IMU ──────────────────────────────────────────────────── */
    if (IMU_Init(&imu_ctx, &hi2c1) == 0)
        printf("LSM6DSO IMU:   OK\r\n");
    else
        printf("LSM6DSO IMU:   FAIL\r\n");

    /* ── ToF ──────────────────────────────────────────────────── */
    if (TOF_Init(&hi2c1) == 0)
        printf("VL53L1X ToF:   OK\r\n");
    else
        printf("VL53L1X ToF:   FAIL\r\n");

    printf("\r\nReady. Send commands (e.g. R3 90, L5 45, STATUS, STREAM)\r\n> ");
    /* USER CODE END 2 */

    /* Infinite loop */
    while (1)
    {
        /* USER CODE BEGIN WHILE */

        /* ── Poll for incoming UART bytes ──────────────────────── */
        uart_poll();

        /* ── Handle completed command ───────────────────────────── */
        if (cmd_ready) {
            cmd_ready = 0;
            process_command(cmd_buf);
            printf("> ");   /* prompt for next command */
        }

        /* ── Streaming sensor output ───────────────────────────── */
        if (stream_on && HAL_GetTick() >= next_stream_ms) {
            next_stream_ms = HAL_GetTick() + STREAM_INTERVAL_MS;

            IMU_Read(&imu_ctx, &imu_data);
            IMU_Print(&imu_data);

            int8_t got = TOF_Read(&tof_data);
            if (got == 1) TOF_Print(&tof_data);
        }

        /* ── Heartbeat LED ─────────────────────────────────────── */
        static uint32_t last_led = 0;
        if (HAL_GetTick() - last_led >= 500) {
            last_led = HAL_GetTick();
            HAL_GPIO_TogglePin(LED_GREEN_GPIO_Port, LED_GREEN_Pin);
        }

        /* USER CODE END WHILE */
    }
}

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
void MPU_Config(void)
{
    MPU_Region_InitTypeDef MPU_InitStruct = {0};

    HAL_MPU_Disable();

    MPU_InitStruct.Enable           = MPU_REGION_ENABLE;
    MPU_InitStruct.Number           = MPU_REGION_NUMBER0;
    MPU_InitStruct.BaseAddress      = 0x0;
    MPU_InitStruct.Size             = MPU_REGION_SIZE_4GB;
    MPU_InitStruct.SubRegionDisable = 0x87;
    MPU_InitStruct.TypeExtField     = MPU_TEX_LEVEL0;
    MPU_InitStruct.AccessPermission = MPU_REGION_NO_ACCESS;
    MPU_InitStruct.DisableExec      = MPU_INSTRUCTION_ACCESS_DISABLE;
    MPU_InitStruct.IsShareable      = MPU_ACCESS_SHAREABLE;
    MPU_InitStruct.IsCacheable      = MPU_ACCESS_NOT_CACHEABLE;
    MPU_InitStruct.IsBufferable     = MPU_ACCESS_NOT_BUFFERABLE;
    HAL_MPU_ConfigRegion(&MPU_InitStruct);

    HAL_MPU_Enable(MPU_PRIVILEGED_DEFAULT);
}

void Error_Handler(void)
{
    __disable_irq();
    while (1) {}
}

#ifdef USE_FULL_ASSERT
void assert_failed(uint8_t *file, uint32_t line)
{
    (void)file; (void)line;
}
#endif
