Jiggolino/Hexapod/firmware/Mainboard_code_V1/Mainboard_code_V1.ioc

Mcu.UserName=STM32H743ZITx
PA0.GPIO_Label=Right_Current_Sense
PA0.Signal=ADC1_INP16
PA4.GPIO_Label=Left_A2
PA4.Signal=GPIO_Output
PA5.GPIO_Label=Left_A1
PA5.Signal=GPIO_Output
PA6.GPIO_Label=Left_A0
PA6.Signal=GPIO_Output
PA8.GPIO_Label=DIN_WS2812B_1
PA8.Signal=S_TIM1_CH1
PA9.GPIO_Label=DIN_WS2812B_2
PA9.Signal=S_TIM1_CH2
PB0.GPIO_Label=Right_Enable
PB0.Signal=GPIO_Output
PB10.GPIO_Label=Right_A1
PB10.Signal=GPIO_Output
PB11.GPIO_Label=Right_A0
PB11.Signal=GPIO_Output
PB6.GPIO_Label=UART_TX_SERIAL
PB6.Signal=USART1_TX
PB7.GPIO_Label=UART_RX_SERIAL
PB7.Signal=USART1_RX
PB8.Signal=I2C1_SCL
PB9.Signal=I2C1_SDA
PC0.GPIO_Label=Left_Current_Sense
PC0.Signal=ADCx_INP10
PD10.GPIO_Label=User_Button
PD10.Signal=GPIO_Input
PD15.GPIO_Label=XSHUT
PD15.Signal=GPIO_Output
PD2.GPIO_Label=LED_CAM
PD2.Signal=GPIO_Output
PE15.GPIO_Label=Right_A2
PE15.Signal=GPIO_Output
PE2.GPIO_Label=LED_GREEN
PE2.Signal=GPIO_Output
PE4.GPIO_Label=LED_RED
PE4.Signal=GPIO_Output
PF3.GPIO_Label=Battery_Voltage
PF3.Signal=ADC3_INP5
PG2.GPIO_Label=GPIO_1_TOF
PG2.Signal=GPIO_Input
PG3.GPIO_Label=Left_Enable
PG3.Signal=GPIO_Output
