Jiggolino/Hexapod/(commit log)

2025-09-12 Initial commit with LFS
    [Hexapod_maximal_estimated_price.xlsx, Mainboard.kicad_pcb, Mainboard.kicad_sch, Parts.xlsx, led_strips.kicad_pcb, led_strips.kicad_sch, untitled.kicad_sch]
2025-09-17 Anforderungen und zeitplan
    [Hexapod_maximal_estimated_price.xlsx]
2025-09-22 work log excel update
    [Hexapod_Anforderung_250916.xlsx, work_log.xlsx]
2025-09-23 3D Print files
    [Conector.3mf, Foot.3mf, Lower Leg hoop left and right.3mf, Lower Leg.3mf, Middle Leg Front and back.3mf, Upper Leg conector and all hoops.3mf, Upper Leg lower hoop left.3mf, Upper Leg lower hoop right.3mf]
2025-09-26 sliced and Prined 3D files
    [Middle Leg Front and back.3mf, Upper Leg all hoops.3mf, Upper Leg conector.3mf, Upper Leg lower hoop left.3mf, Upper Leg lower hoop right.3mf]
2025-09-29 cad Changes
2025-09-30 Leg V2 step/stl fies
2025-11-03 random upload
    [EDI2CAP.CFG, GMR50HJAAFD5L00.stp, MUX508IDR.step, PCA9685PW_Q900,118.stp, PCA9685PW_Q900_118.SchLib, SOP65P640X110-28N.PcbLib, XT60PW-M--3DModel-STEP-269445.STEP, XT60PW-M.step]
2025-11-11 Stripe PCB's
    [EDI2CAP.CFG, GMR50HJAAFD5L00.stp, MUX508IDR.step, PCA9685PW_Q900,118.stp, PCA9685PW_Q900_118.SchLib, SOP65P640X110-28N.PcbLib, XT60PW-M--3DModel-STEP-269445.STEP, XT60PW-M.step]
2025-11-17 STM32 Mainboard requirements for Programing and Power
    [3.3V.kicad_sch, 5V.kicad_sch, front.kicad_pcb, mainboard.kicad_sch, powerstrip_right.kicad_pcb]
2025-11-20 upgrades to STM32 Board
    [3.3V.kicad_sch, 5V.kicad_sch, MCU_Configuration.kicad_sch, MCU_PWR_SUPPLIES.kicad_sch, mainboard.kicad_pcb]
2025-11-28 Made the Mainboard BCP Part Layout
    [3.3V.kicad_sch, 5V.kicad_sch, EDI2CAP.CFG, GMR50HJAAFD5L00.stp, MCU_Configuration.kicad_sch, MCU_PWR_SUPPLIES.kicad_sch, XT60PW-M--3DModel-STEP-269445.STEP, XT60PW-M.step]
2025-12-02 Stop tracking renders folder & final Powerstrip and Mainboard PCB
    [150060GS75000.SchLib, 150060GS75000.stp, 1735265-8.SchLib, 1735265-8.stp, 17352658.PcbLib, 17352658.psm, 3.3V.kicad_sch, 5V.kicad_sch]
2026-01-07 Doku + new License
    [bom.csv, designators.csv, front.kicad_pcb, positions.csv, powerstrip_left.kicad_pcb, powerstrip_right.kicad_pcb, work_log.xlsx]
2026-01-07 Doku and cleaning up
    [Conector.3mf, Conector.step, Done_Lower Leg hoop left.3mf, Done_Lower Leg.3mf, Done_Upper Leg upper hoop bottom.3mf, Foot.step, Hexapod_Anforderung_250916.xlsx, IO Shield.3mf]
2026-01-12 random save
    [Hexapod_Anforderung_250916.xlsx, Parts.xlsx, parts.xlsx, work_log.xlsx]
2026-02-19 svaing project
    [TEST_CODE Release.cfg, bom.csv, designators.csv, positions.csv]
2026-02-26 radnom upload
    [bom.csv, designators.csv, positions.csv]
2026-03-12 timeplan upload
    [Hexapod_Anforderung_250916.xlsx, work_log.xlsx]
2026-03-12 Preperation 2 Semester
    [Hexapod_Anforderung_250916.xlsx, TEST_CODE Release.cfg, bom.csv, designators.csv, hexapod_maximal_estimated_price.xlsx, positions.csv, work_log.xlsx]
2026-03-16 servo numbers
    [bom.csv, designators.csv, positions.csv]
2026-04-13 Kicad PCBS 10.0 and git errors resolve
    [3.3V.kicad_sch, 5V.kicad_sch, MCU_Configuration.kicad_sch, MCU_PWR_SUPPLIES.kicad_sch, front.kicad_pcb, front.kicad_sch, mainboard.kicad_pcb, mainboard.kicad_sch]
2026-04-13 Kicad 10.0 integration and PCB Coruption resolved
    [Conector.step, EDI2CAP.CFG, Foot.step, GMR50HJAAFD5L00.stp, Hexapod_clean.xacro, Lower Leg hoop left.step, Lower Leg hoop right.step, Middle Leg Back.step]
